BTSC10/Oreo/PCB/Kicad/Main-Board/v1.1/Melty_back.png

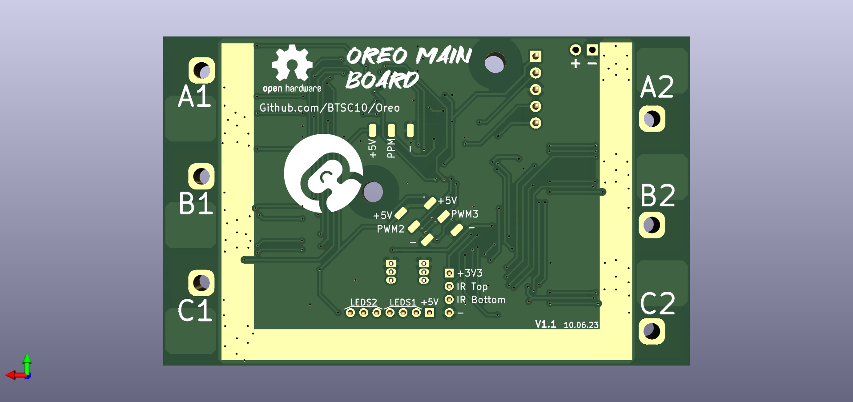
PCB/Kicad/Main-Board/v1.1/Melty_back.png
