BTSC10/Oreo/PCB/Kicad/Daughter-Board/Melty-daughter_top.png

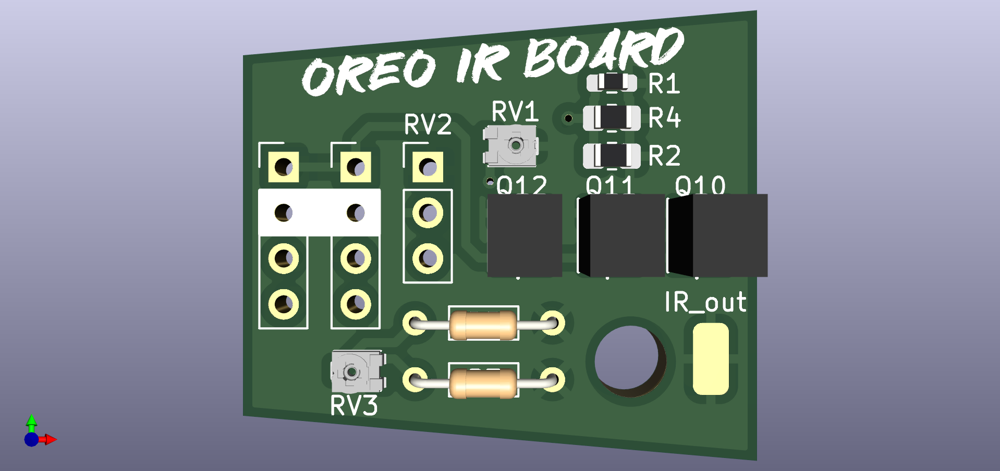
PCB/Kicad/Daughter-Board/Melty-daughter_top.png
