BTSC10/Oreo/README.md

# Broos
Beetle-weight Melty Brain Combat Robot.
(dont read me)
(please don't)
Ily's new edit

Name Ideas:
***********
Broos

You spin my head round

Oreo

<name>

Spinn

Oooga Booga

(Atak go) Brrr

Toothless
