BTSC10/Oreo/PCB/Oreo-v1.0-JLCPCB-invoice.pdf

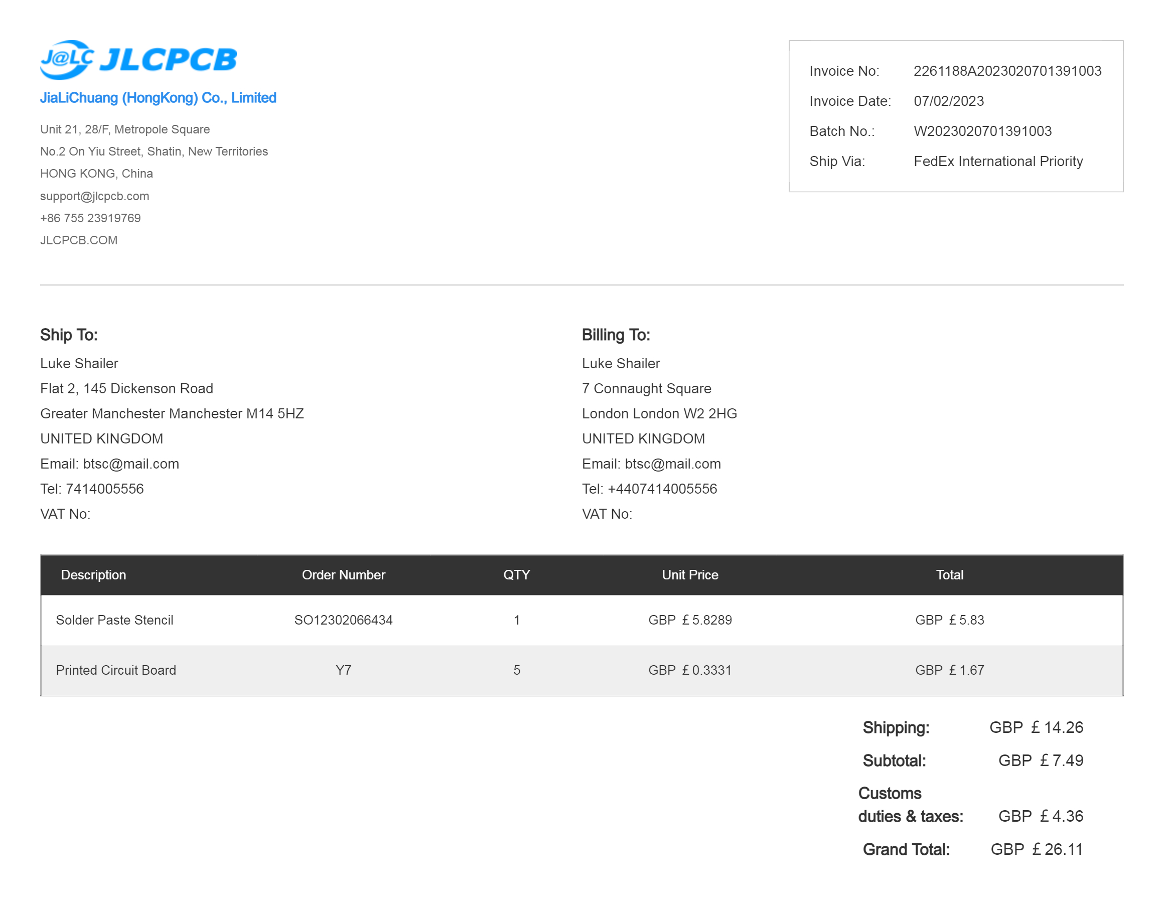
[picture p3: figure]
