BTSC10/Oreo/CAD/Render.JPG

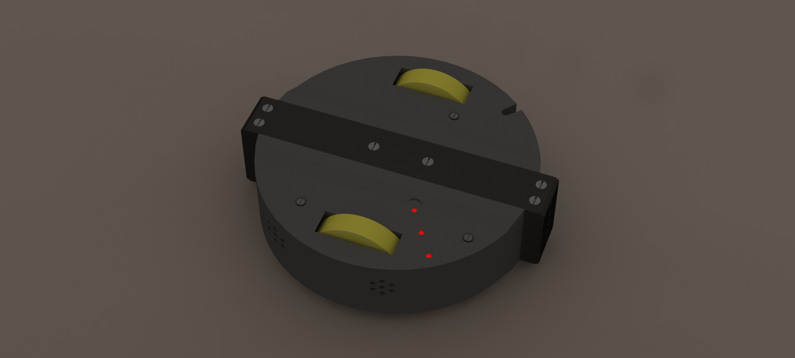
CAD/Render.JPG
