BTSC10/Oreo/PCB/Kicad/Beacon-driver/Beacon-driver_bottom.png

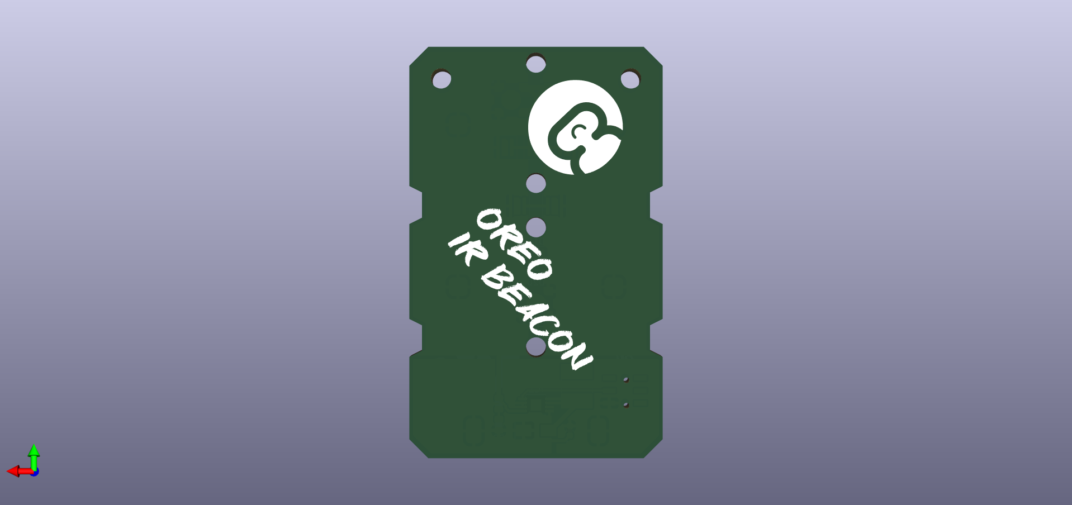
PCB/Kicad/Beacon-driver/Beacon-driver_bottom.png
