BTSC10/Oreo/PCB/Kicad/Beacon-driver/Beacon-driver_top.png

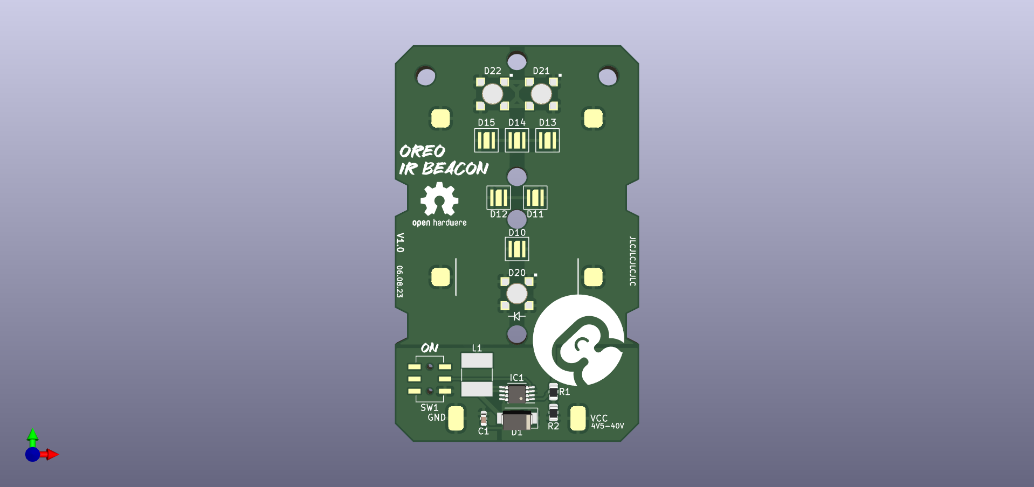
PCB/Kicad/Beacon-driver/Beacon-driver_top.png
