BTSC10/Oreo/PCB/Kicad/Daughter-Board/Melty-daughter_bottom.png

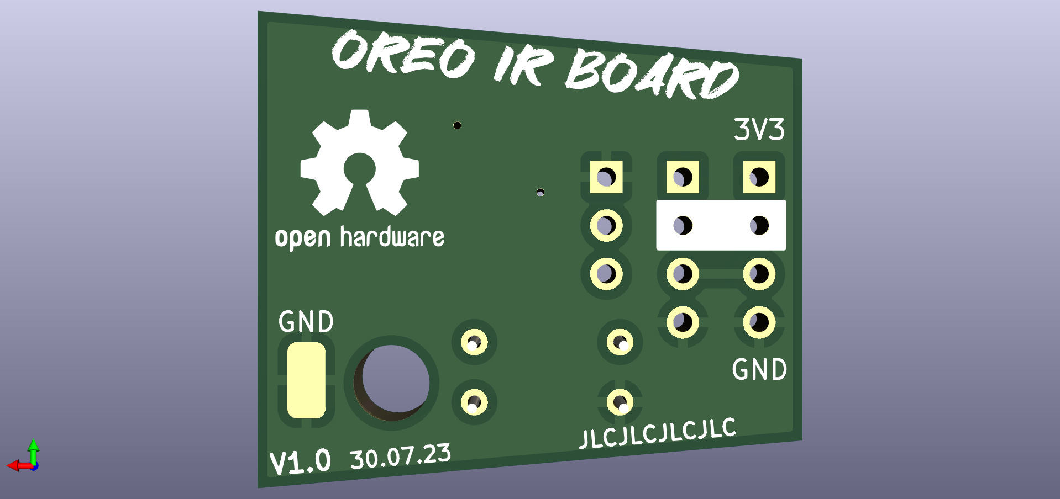
PCB/Kicad/Daughter-Board/Melty-daughter_bottom.png
