BTSC10/Oreo/PCB/Kicad/Main-Board/v1.1/Gerbers/drill_gen_settings.jpg

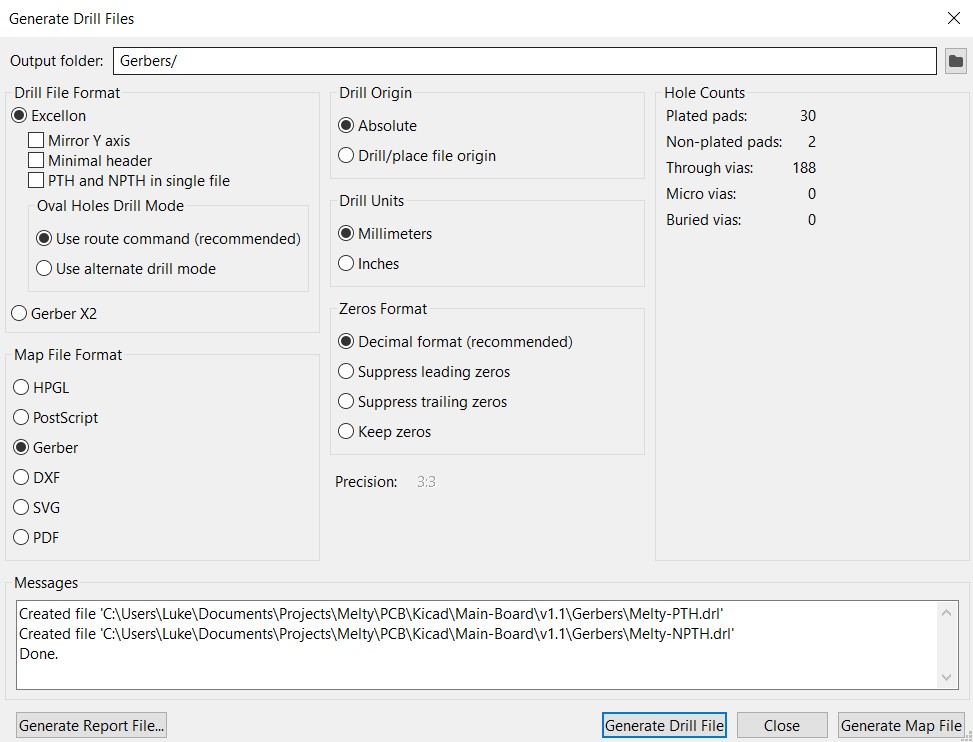
PCB/Kicad/Main-Board/v1.1/Gerbers/drill_gen_settings.jpg
