BTSC10/Oreo/PCB/Kicad/Main-Board/v1.1/Gerbers/gerber_gen_settings.jpg

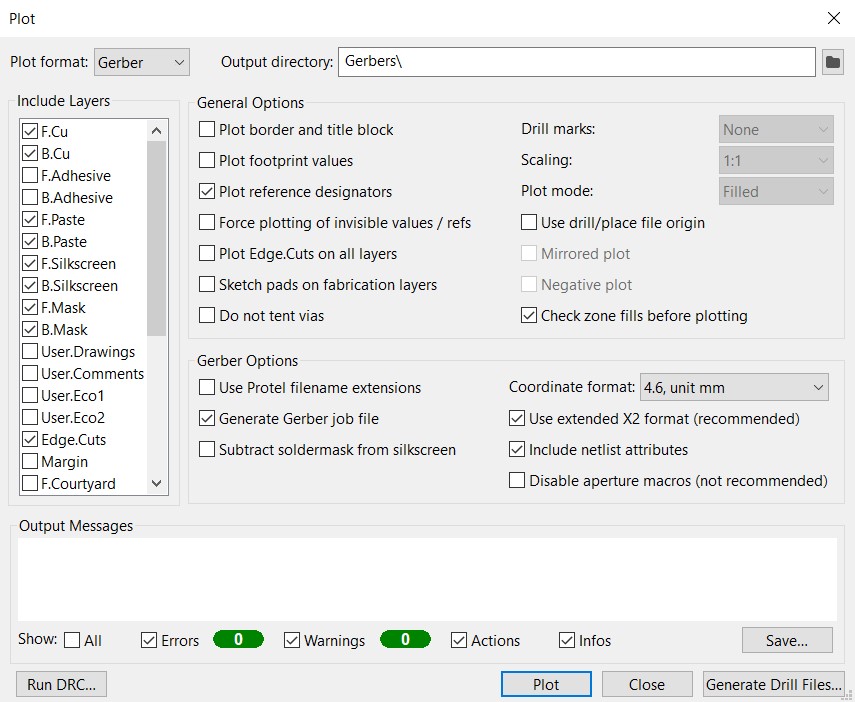
PCB/Kicad/Main-Board/v1.1/Gerbers/gerber_gen_settings.jpg
