BTSC10/Oreo/BOM.xlsx

Sheet: Main Board BOM
Ref | Man # | Min Qnty | Qnty | Unit Price | Description | Footprint | Supplier Link | Datasheet
AC1, | H3LIS331DLTR | 1 | 2 | £11.91 | Accelerometers Low Pwr Hi G 3-axis Digital Acceleromtr |  | https://www.digikey.co.uk/en/products/detail/H3LIS331DLTR/497-13903-1-ND/4311636 | https://www.st.com/content/ccc/resource/technical/document/datasheet/3e/48/02/c7/a4/e6/41/bb/DM00053090.pdf/files/DM00053090.pdf/jcr:content/translations/en.D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
C1, C16, C19, C20, C21, C22, C23, | CL21B105KAFNNNE | 7 | 20 | £0.057 | CAP CER 1UF 25V X7R 0805 | 0805 | https://www.digikey.co.uk/en/products/detail/samsung-electro-mechanics/CL21B105KAFNNNE/3886724 | https://media.digikey.com/pdf/Data%20Sheets/Samsung%20PDFs/CL21B105KAFNNNE_Spec.pdf
C2, C4, | TCC0402COG200J500AT | 2 | 100 | £0.001 | 50V 20pF C0G Â±5% 0402 Multilayer Ceramic Capacitors MLCC - SMD/SMT ROHS | 0402 | 100
C3, C5, C7, C14, | CL05A106MQ5NUNC | 4 | 50 | £0.003 | 6.3V 10uF X5R Â±20% 0402 Multilayer Ceramic Capacitors MLCC - SMD/SMT ROHS | 0402 | 50
C6, C17, C18, C24, C25, C26, C27, | CL31A106KAHNNNE | 7 | 20 | £0.110 | CAP CER 10UF 25V X5R 1206 | 1206 | https://www.digikey.co.uk/en/products/detail/samsung-electro-mechanics/CL31A106KAHNNNE/3886733
C8, | CC0402KRX7R9BB103 | 1 | 100 | £0.001 | 10nF | 0402 | 100
C9, | CL10A475KA8NQNC | 1 | 20 | £0.019 | 25V 4.7uF X5R Â±10% 0603 Multilayer Ceramic Capacitors MLCC - SMD/SMT ROHS | 0603 | 20
C10, C11, C12, C13, C15, | TCC0402X5R104M250AT | 5 | 200 | £0.001 | 25V 100nF X5R Â±20% 0402 Multilayer Ceramic Capacitors MLCC - SMD/SMT ROHS | 0402 | 200
D2, | XL-1608SYGC-06 | 1 | 50 |  | Green LED 25mA 2800K~3160K 575nm Colorless transparence -30â„ƒ~+85â„ƒ Positive post 570nm~573nm Green/Yellow-Green 120Â° 55mW 0603 Light Emitting Diodes (LED) ROHS | 0603 | 50
L1, | CBC3225T102KR | 1 | 10 |  | 1mH | 1210 | 10
Q1, Q2, Q5, Q6, Q7, Q8, Q9, Q10, Q11, Q12, Q13, Q14, | STD80N3LL | 12 |  |  |  | TO-252-2 | https://uk.farnell.com/stmicroelectronics/std80n3ll/mosfet-n-ch-30v-80a-to-252/dp/4036303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|pcrid|610187768070|&gclid=Cj0KCQjwz8emBhDrARIsANNJjS6BriV4xIs_x6XmtyKd7ZRa-XmyrBPjHKZbWgFfGnDnOGN-Ei2ZlYcaAudcEALw_wcB
Q1, Q2, Q5, Q6, Q7, Q8, Q9, Q10, Q11, Q12, Q13, Q14, | G35N02K | 12 | 24 | £0.371 | N-Channel 20 V 35A (Tc) 40W (Tc) Surface Mount TO-252 | TO-252-2 | https://www.digikey.co.uk/en/products/detail/goford-semiconductor/G35N02K/16584942 | http://www.gofordsemi.com/products-detail.php?ProId=637
R1, R4, R22, R23, R24, R25, R26, R27, | 0402WGJ0823TCE | 8 | 200 | £0.0004 | 82K | 0402 | 200
R3, | - | 1 | 50 |  | 500R | 0805 | 50
R5, R28, R29, R30, R31, R32, R33, | RC-02W1402FT | 7 | 200 | £0.001 | 14K | 0402 | 200
R6, R7, R10, R11, R12, R13, R14, R15, R16, R17, R18, R19, | ERJ-PA2F20R0X | 12 | 24 | £0.173 | RES 20 OHM 1% 1/4W 0402 | 0402 | https://www.digikey.co.uk/en/products/detail/panasonic-electronic-components/ERJ-PA2F20R0X/9815036
U1, | AP7375-33SA-7 | 1 | 3 | £0.370 | 3.3 V Linear Voltage Regulator IC Positive Fixed 1 Output 300mA SOT-23-3 | SOT-23 | https://www.digikey.co.uk/en/products/detail/diodes-incorporated/AP7375-33SA-7/16400213 | https://www.diodes.com/assets/Datasheets/AP7375.pdf
U2, U8, | NCR421UX | 0 | 10 | £0.380 | IC LED DRVR LIN PWM 150MA 6TSOP | TSOP-6_1.65x3.05mm_P0.95mm | https://www.digikey.co.uk/en/products/detail/nexperia-usa-inc/NCR421UX/9998332
U3, | STM32F303RBTx | 1 | 10 | £4.500 | ARM Cortex-M4 MCU, 128KB flash, 32KB RAM, 72MHz, 2-3.6V, 52 GPIO, LQFP-64 | LQFP-64_10x10mm_P0.5mm | 10
U4, U7, | DRV8300DRGER | 2 | 5 | £1.400 | 100-V MAX SIMPLE 3-PHASE GATE DR | VQFN-24-1EP_4x4mm_P0.5mm_EP2.45x2.45mm | https://www.digikey.co.uk/en/products/detail/texas-instruments/DRV8300DRGER/13918763 | https://www.ti.com/lit/ds/symlink/drv8300.pdf?HQS=dis-dk-null-digikeymode-dsf-pf-null-wwe&ts=1667935104197
U10, | PJ73AL50SQ | 1 | 10 | £0.102 | 300mA 300mV@(100mA) Fixed 5V~5V Positive 1 20V SOT-89 Linear Voltage Regulators (LDO) ROHS | SOT-89-3 | 10
Y1, | 2344-RH100-32.000-20-F-5050-TR-NS1CT-ND | 1 | 10 |  | CRYSTAL 32.0000MHZ 20PF SMD | Crystal_SMD_3225-4Pin_3.2x2.5mm | 10
 | PCB | 1 | 10 | £0.400
 | Total: | £27.83 | £103.26

Sheet: IR Board BOM
Ref | Man # | Min Qnty | Qnty | Unit Price | Description | Footprint | Supplier Link | Datasheet
D1, D2, | B3803FCH-20C001112U1930 | 0 | 8 | £0.180 | LED RGB FULL COLOR 1.6X1.6 | - | https://www.digikey.co.uk/en/products/detail/harvatek-corporation/B3803FCH-20C001112U1930/13588742
Q1, | SFH 325 | 1 | 10 | £0.640 | SENSOR PHOTO 980NM SIDE VIEW SMD |  | https://www.digikey.co.uk/en/products/detail/osram-opto-semiconductors-inc/SFH-325-FA-3-4-Z/3880928
RV1, | TC42X-2-102E | 1 | 5 | £0.430 | TRIMMER 1K OHM 0.1W J LEAD TOP | - | https://www.digikey.co.uk/en/products/detail/bourns-inc/TC42X-2-102E/3722194
 | PCB | 1 | 5 | £0.400
 | Total: | £1.47 | £11.99
 | 2 units needed

Sheet: IR Beacon BOM
Ref | Man # | Min Qnty | Qnty | Unit Price | Description | Footprint | Digikey Link | Datasheet
IC1 | AL8860MP-13 | 1 | 4 | £0.73 | LED Driver, 1 Output, Buck (Step Down), 4.5 V to 40 V in, 1 MHz switch, PWM, 40V/1.5 A out, MSOP-8 | MSOP-8 | https://uk.farnell.com/diodes-inc/al8860mp-13/led-driver-buck-1mhz-msop-8/dp/2709526
L1 | VLS6045EX-470M-H | 1 | 3 | £0.360 | Power Inductor (SMD), AEC-Q200, 47 µH, 1.3 A, Semishielded, 1.8 A, VLS-EX-H | - | https://uk.farnell.com/tdk/vls6045ex-470m-h/inductor-aec-q200-47uh-semi-shld/dp/3288287 | https://www.farnell.com/datasheets/2875164.pdf
D2 | ES2AA | 1 | 5 | £0.080 | Fast / Ultrafast Diode, 50 V, 2 A, Single, 920 mV, 25 ns, 50 A | SMA? | https://uk.farnell.com/diodes-inc/es2aa/diode-rectif-s-fast-2a-50v-sma/dp/2061427 | https://www.farnell.com/datasheets/2211370.pdf
R1 | MFLA0805R1000FA | 1 | 10 | £0.090 | SMD Current Sense Resistor, 0.1 ohm, MFLA Series, 0805 [2012 Metric], 250 mW, ± 1%, Metal Film | 0805 | https://fr.farnell.com/en-FR/eaton-bussmann/mfla0805r1000fa/res-r1-1-0-25w-metal-film-0805/dp/4070738
D0x | LZ1-10R702-0000 | 1 | 2 | £8.330 | Infrared (IR) Emitter 940nm 3V 1.2A 90° Star Array | Star Array | https://www.digikey.co.uk/en/products/detail/osram-opto-ams-osram/LZ1-10R702-0000/4976715
D1x | SE03-EMC3838A-C90-940 | 1 | 3 | £1.580 | 180mW~240mW 1000mA 1.3V~1.7V 1.7W 930nm~960nm SMD,3.9x3.9mm Infrared (IR) LED |  | https://www.lcsc.com/product-detail/Infrared-IR-LEDs_XSSY-SE03-EMC3838A-C90-940_C5205231.html
SW1 | TA-3539S-A1 | 1 | 10 | £0.101 | SMD,4x7.2mm Slide Switche |  | https://www.lcsc.com/product-detail/Slide-Switches_Yuandi-TA-3539S-A1_C514054.html | https://datasheet.lcsc.com/lcsc/2004181005_Yuandi-TA-3539S-A1_C514054.pdf
 | PCB | 1 | 5 | £0.800
 | Total: | £12.07 | £31.71

Sheet: Mechanical
Part Name | Material | Volume | Weight | Qty | Unit Price | Link
chassis_poly_top | polycarb | 318419 | 159.2095 | 1 |  |  | Density
chassis_poly_bottom | polycarb | 838261 | 419.1305 | 1 |  |  | HDPE | 0.00095
weapon_bar | Al | 59807.32 | 468.8893888 | 0 |  |  | Silicon | 0.00100
weapon_tooth | tool steel | 72054.76 | 564.9093184 | 0 |  |  | AL | 0.00270
 |  |  |  |  |  |  | Steel | 0.00784
 |  |  |  |  |  |  | ABS | 0.001
3d aim | 550 | 578.34 |  | 1
metal aim | 700 | 684.88 | 684.88 | 1 |  | 2067.597414
Wheel_Inner | ABS? | 2000 | 2 | 2
Wheel_Outer | Silicon | 5000 | 5 | 2
M3 10-15mm contersunk screw | - |  | 1 | 16
prop 2830 800kv |  |  | 65 | 2 | £18.43 | https://hobbyking.com/en_us/propdrive-v2-2830-800kv-brushless-outrunner-motor.html
1100mah 4s LiPo |  |  | 137 | 1 | £18.55 | https://www.hobbyrc.co.uk/gnb-1100mah-4s-130c-lipo-battery
Oreo PCB |  |  |  | 1 | £27.83
Daughter PCB |  |  |  | 1
RX |  |  | 5 | 1
Safety Link |  |  |  | 1
Power LED |  |  |  | 1
 | Total Weight: |  | 1565.22
 | Delta: |  | -65.22
1kg 85A Rubber |  |  |  | 1 | £24.00 | https://www.mbfg.co.uk/pt-flex-85-rubber.html
250g softner |  |  |  | 1 | £25.00 | https://www.mbfg.co.uk/7475-c-softener.html
1kg Load Cell |  |  |  | 1 | £4.99 | https://www.amazon.co.uk/ARCELI-Converter-Breakout-Portable-Electronic/dp/B07MY35F92/ref=sr_1_5

Sheet: Calculator
Bar
Diameter | Width | Thickness | Volume | Weight | Target
225 | 35 | 3.2 | 25200 | 68.04 | 175
 |  |  |  |  |  | 750
Tooth
Depth | Width | Height | Volume
20 | 35 | 50 | 35000 | 274.4 | 200
 |  |  |  | 684.88 | 700
Balance
4 | 25 | 50 | 5000 | 39.2 | 50
# | di
5 | 5 |  | 1570.796327 | 12.3150432
 |  |  |  | 51.5150432
