BTSC10/Oreo/CAD/XT60E-F.SLDASM

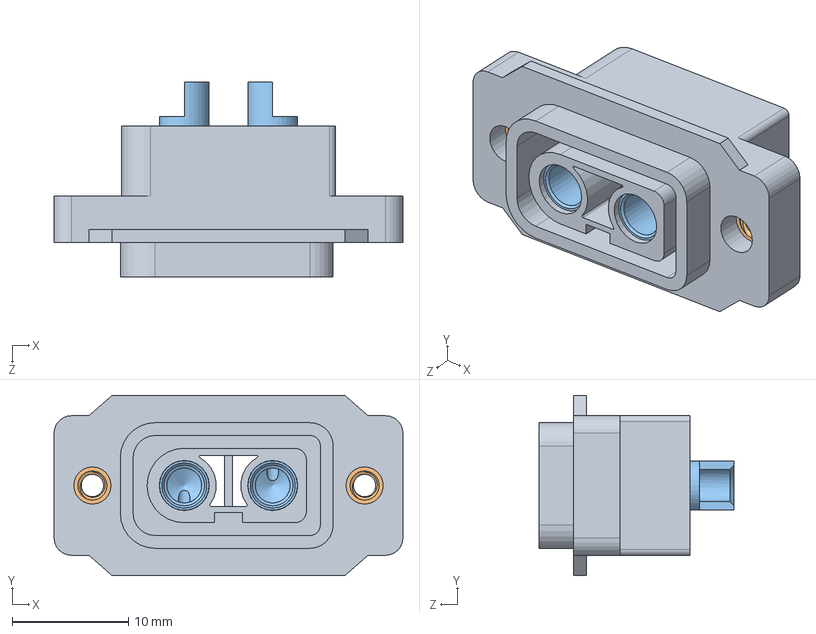
[picture p11: CAD file, 2023-02-22]
CAD/XT60E-F.SLDASM
30.0 x 15.5 x 16.8 mm
Nylon Housing.step
M2.5 Nut.step x 2
Socket 3.5mm.step x 2
