BTSC10/Oreo/CAD/motor_assem.SLDASM

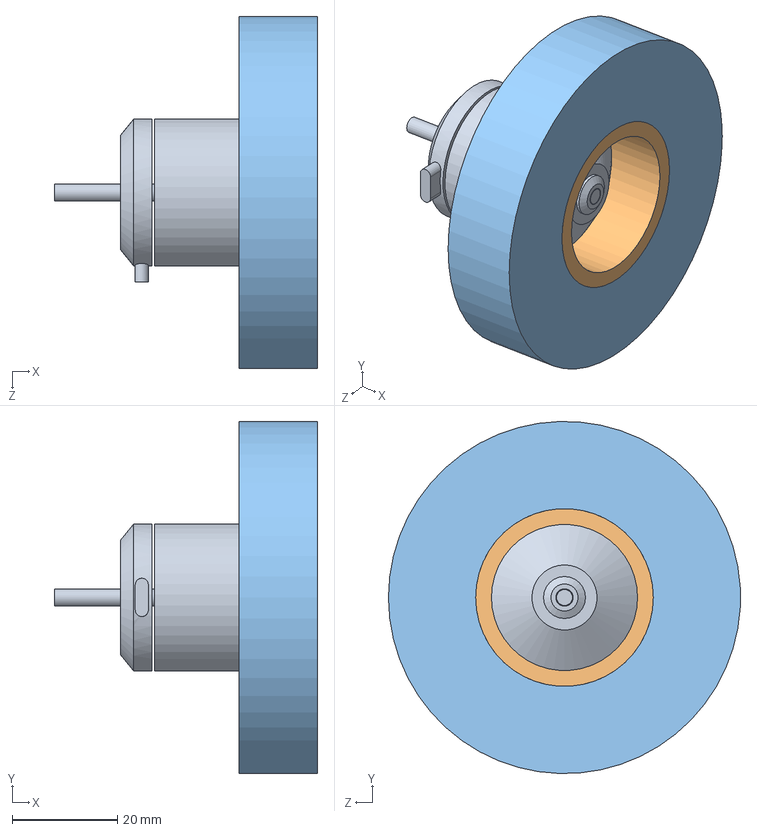
[picture p12: CAD file, 2023-02-22]
CAD/motor_assem.SLDASM
50.1 x 67.0 x 67.0 mm
prop_2830_800kv
DesignA
wheel_silicon
