BTSC10/Oreo/CAD/chassis_poly_top.SLDPRT

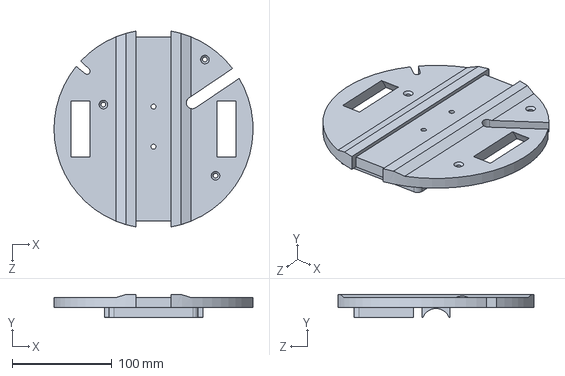
[picture p13: CAD file, 2023-03-05]
CAD/chassis_poly_top.SLDPRT
199.9 x 23.4 x 196.9 mm
