BTSC10/Oreo/CAD/Wheels/Design 1.SLDPRT

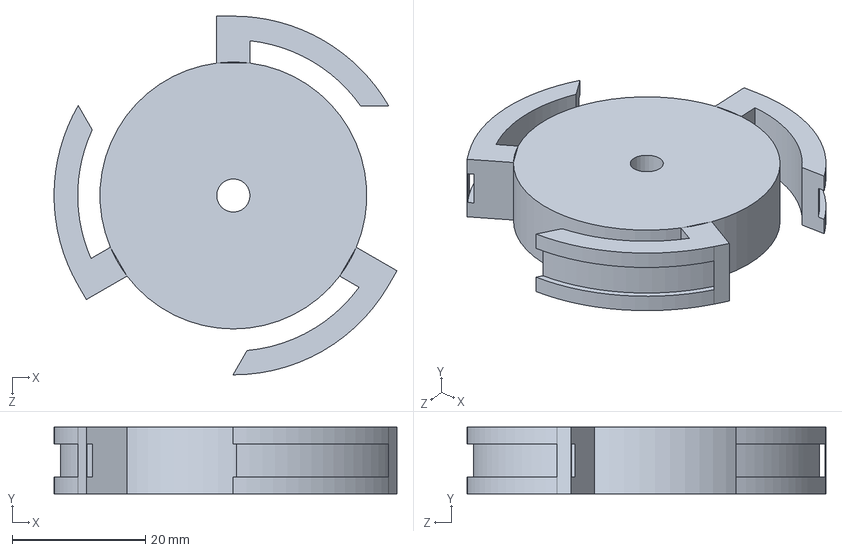
[picture p14: CAD file, 2023-03-08]
CAD/Wheels/Design 1.SLDPRT
51.6 x 10.0 x 53.9 mm
