BTSC10/Oreo/CAD/chassis_poly_bottom.SLDPRT

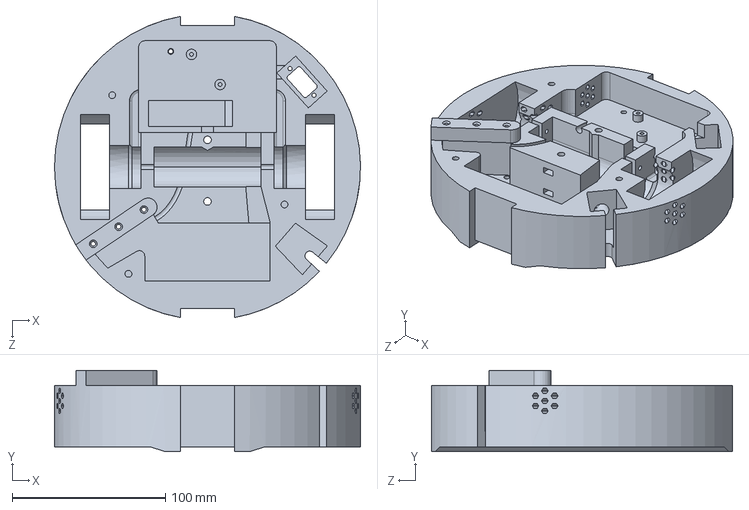
[picture p15: CAD file, 2023-03-05]
CAD/chassis_poly_bottom.SLDPRT
200.0 x 53.2 x 196.9 mm
