BTSC10/Oreo/CAD/Wheels/Wheel mould.SLDPRT

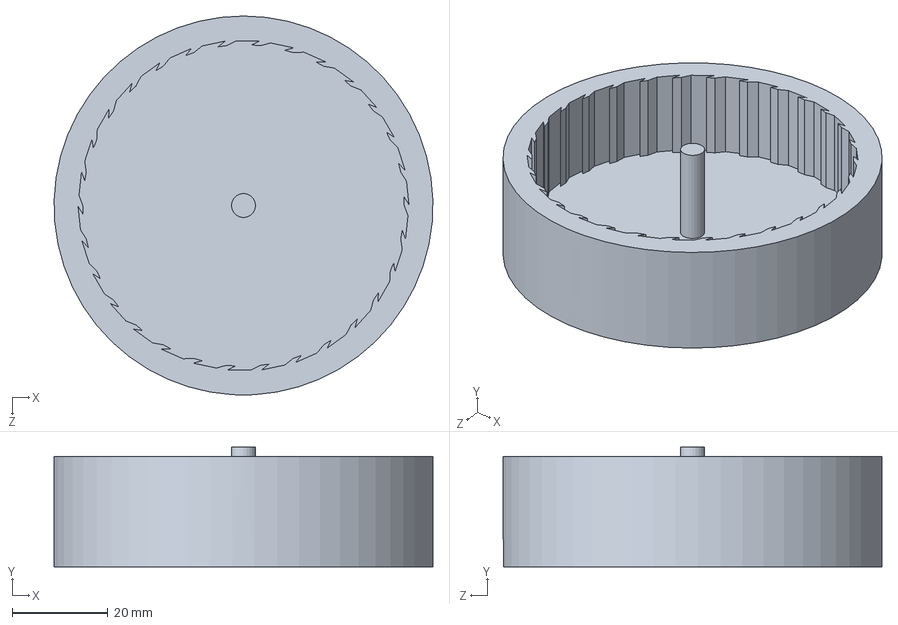
[picture p16: CAD file, 2023-03-08]
CAD/Wheels/Wheel mould.SLDPRT
79.0 x 25.0 x 79.0 mm
