BTSC10/Oreo/CAD/3mm_LED.SLDPRT

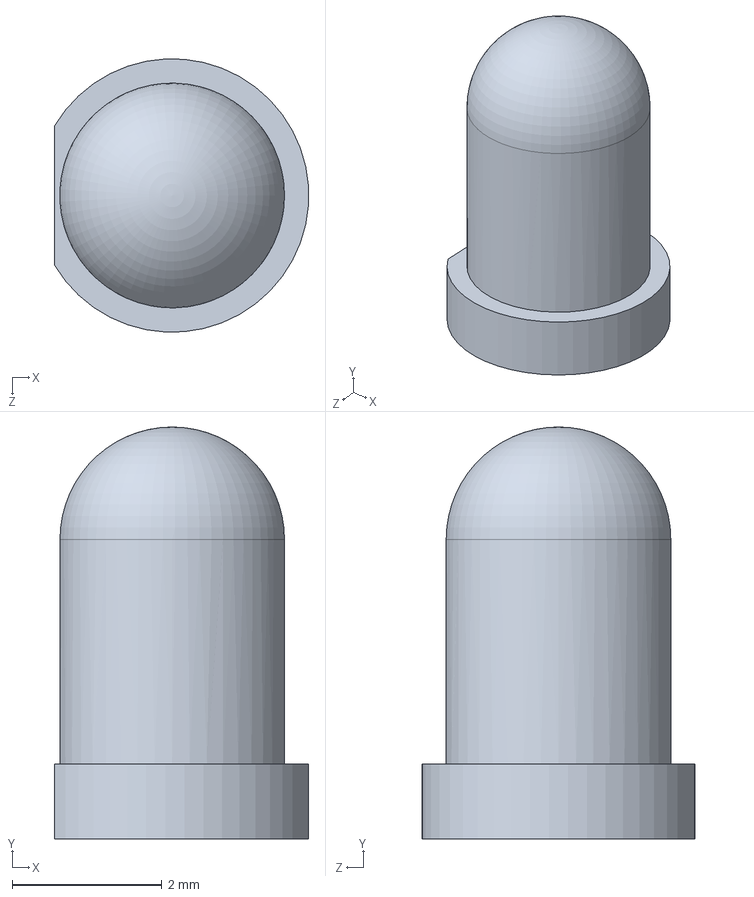
[picture p17: CAD file, 2023-02-22]
CAD/3mm_LED.SLDPRT
3.39 x 5.50 x 3.65 mm
