BTSC10/Oreo/CAD/Wheels/ruber.SLDPRT

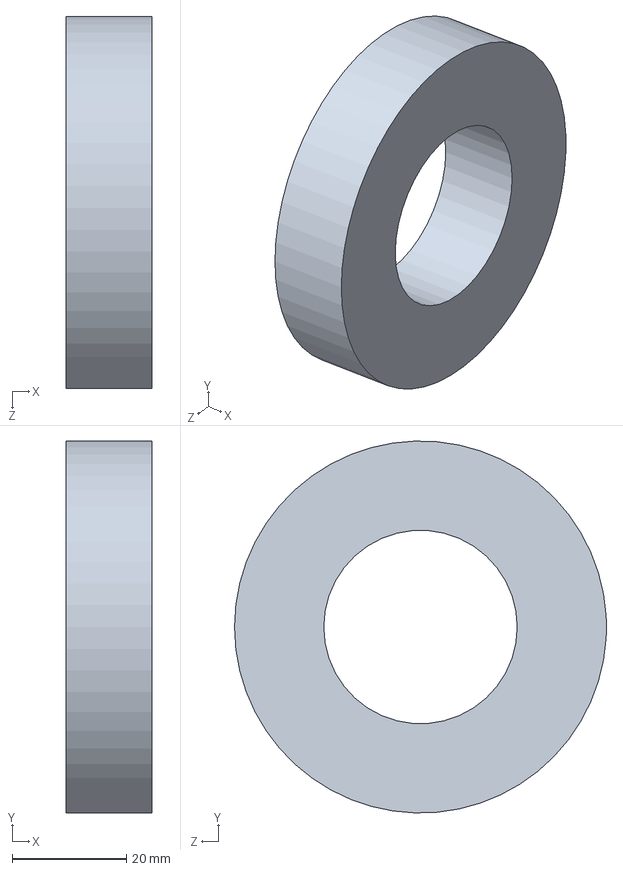
[picture p18: CAD file, 2023-02-22]
CAD/Wheels/ruber.SLDPRT
15.0 x 65.0 x 65.0 mm
