BTSC10/Oreo/CAD/Wheels/wheel_silicon.SLDPRT

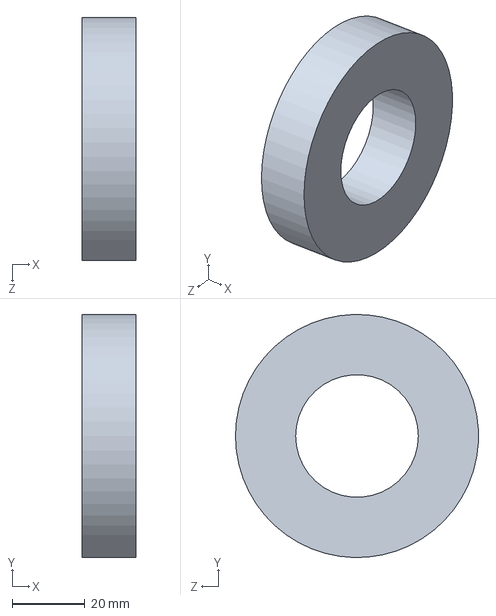
[picture p19: CAD file, 2023-02-22]
CAD/Wheels/wheel_silicon.SLDPRT
15.0 x 67.0 x 67.0 mm
