BTSC10/Oreo/CAD/daughter_pcb.SLDPRT

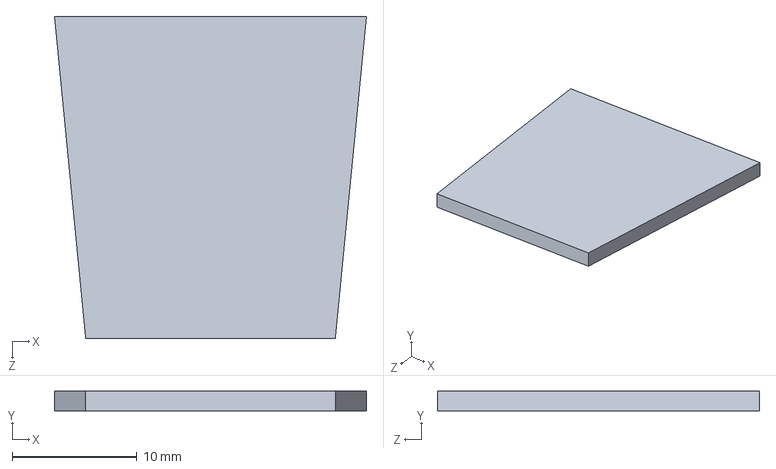
[picture p21: CAD file, 2023-02-22]
CAD/daughter_pcb.SLDPRT
25.0 x 1.60 x 25.8 mm
