BTSC10/Oreo/CAD/Wheels/DesignA.SLDPRT

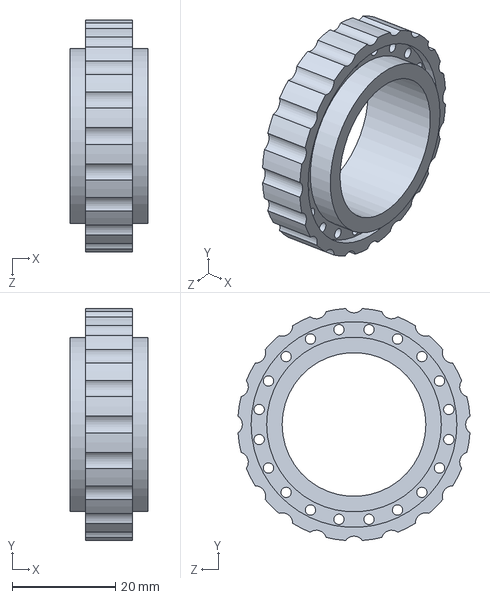
[picture p22: CAD file, 2023-02-22]
CAD/Wheels/DesignA.SLDPRT
15.0 x 44.9 x 44.9 mm
