BTSC10/Oreo/CAD/daughter_pcb_spacer_bottom.SLDPRT

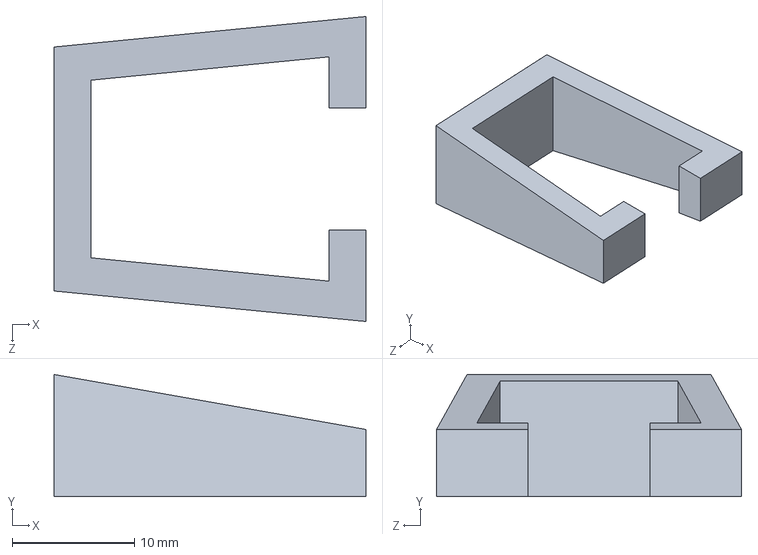
[picture p23: CAD file, 2023-02-22]
CAD/daughter_pcb_spacer_bottom.SLDPRT
25.5 x 10.0 x 25.0 mm
