BTSC10/Oreo/CAD/battery.SLDPRT

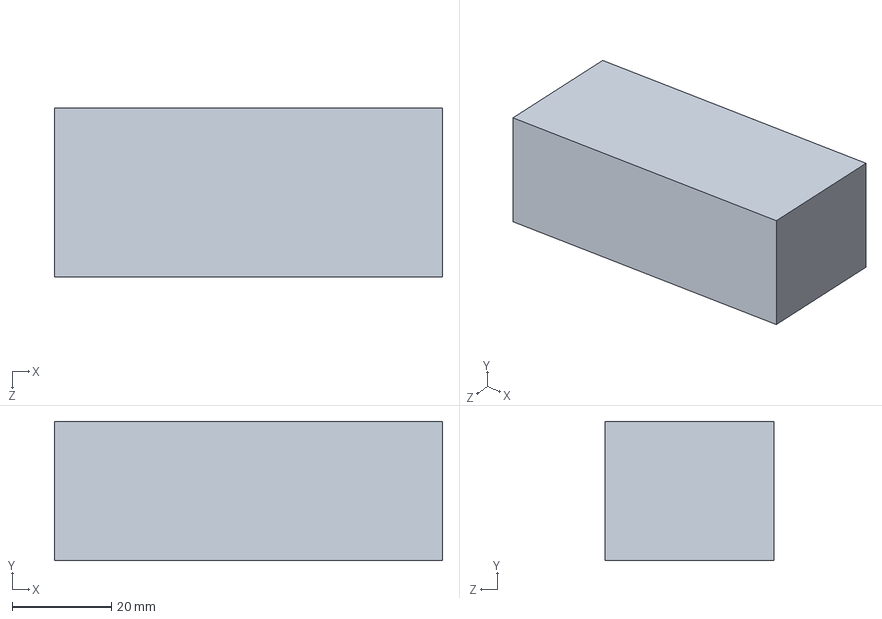
[picture p24: CAD file, 2023-02-22]
CAD/battery.SLDPRT
78.0 x 28.0 x 34.0 mm
