BTSC10/Oreo/CAD/prop_2830_800kv.SLDPRT

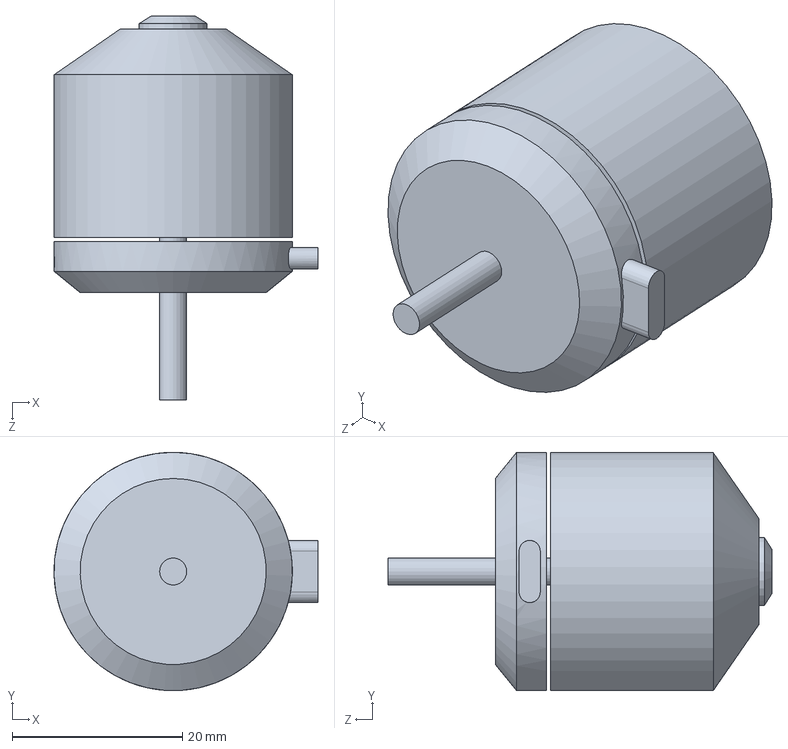
[picture p25: CAD file, 2023-02-22]
CAD/prop_2830_800kv.SLDPRT
31.0 x 28.0 x 45.1 mm
