BTSC10/Oreo/CAD/weapon_bar.SLDPRT

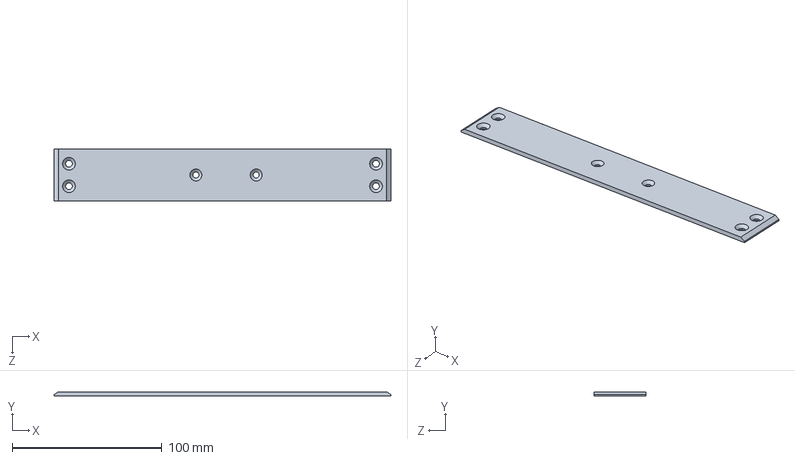
[picture p26: CAD file, 2023-02-22]
CAD/weapon_bar.SLDPRT
225.0 x 3.00 x 35.0 mm
