BTSC10/Oreo/CAD/weapon_tooth.SLDPRT

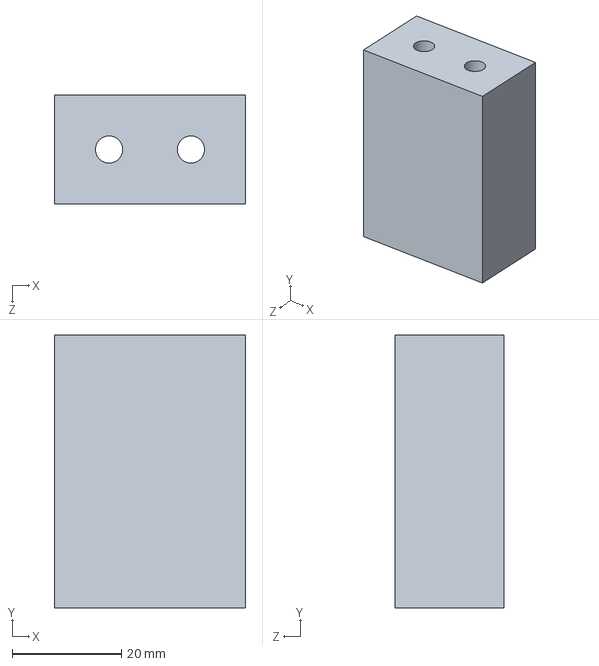
[picture p27: CAD file, 2023-02-22]
CAD/weapon_tooth.SLDPRT
35.0 x 50.0 x 20.0 mm
