BTSC10/Oreo/CAD/daughter_pcb_spacer.SLDPRT

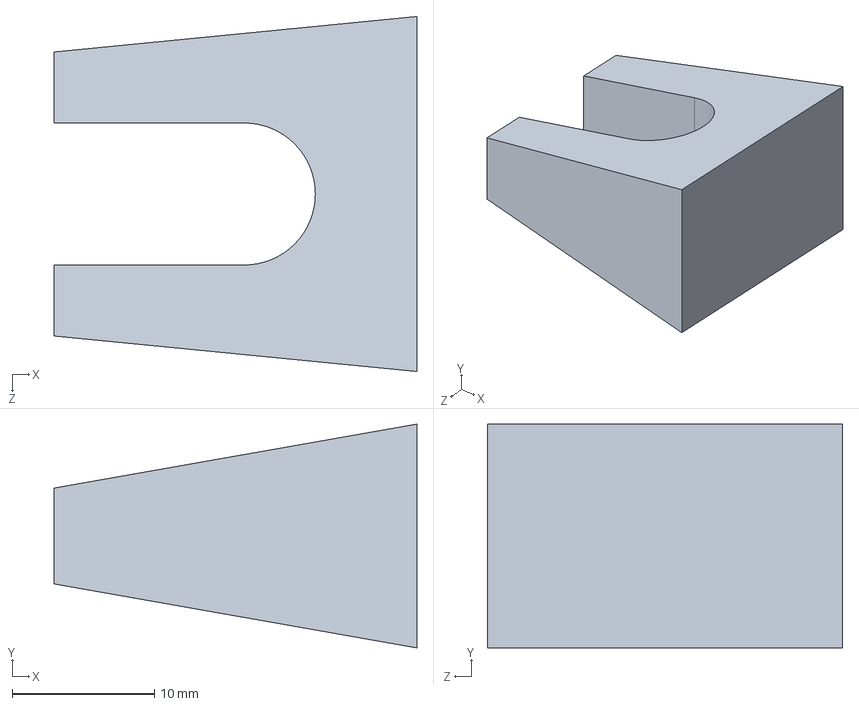
[picture p28: CAD file, 2023-02-22]
CAD/daughter_pcb_spacer.SLDPRT
25.5 x 15.8 x 25.0 mm
