BTSC10/Oreo/CAD/Wheel.SLDPRT

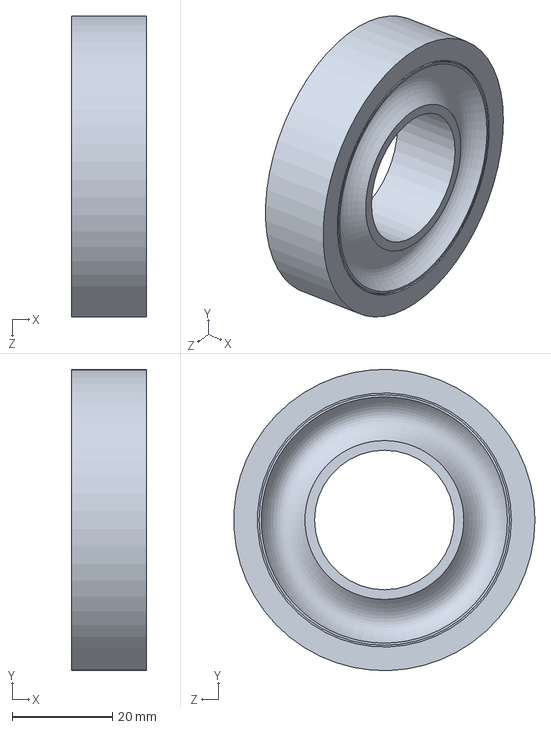
[picture p29: CAD file, 2022-12-09]
CAD/Wheel.SLDPRT
15.0 x 60.0 x 59.9 mm
