BTSC10/Oreo/CAD/C2836_Brushless_Motor.SLDPRT

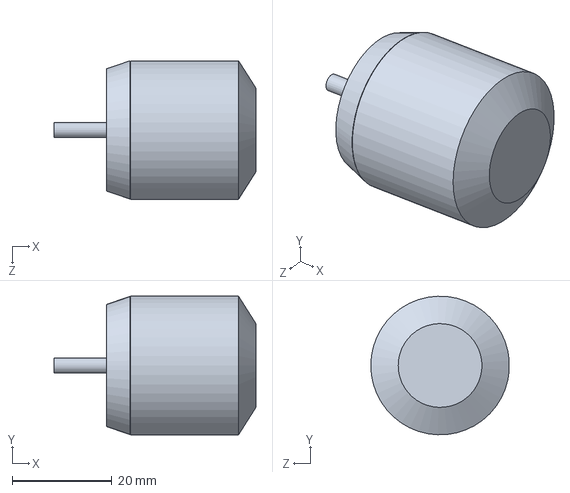
[picture p30: CAD file, 2022-12-09]
CAD/C2836_Brushless_Motor.SLDPRT
40.5 x 27.8 x 27.8 mm
