BTSC10/Oreo/CAD/Mock_PCB.SLDPRT

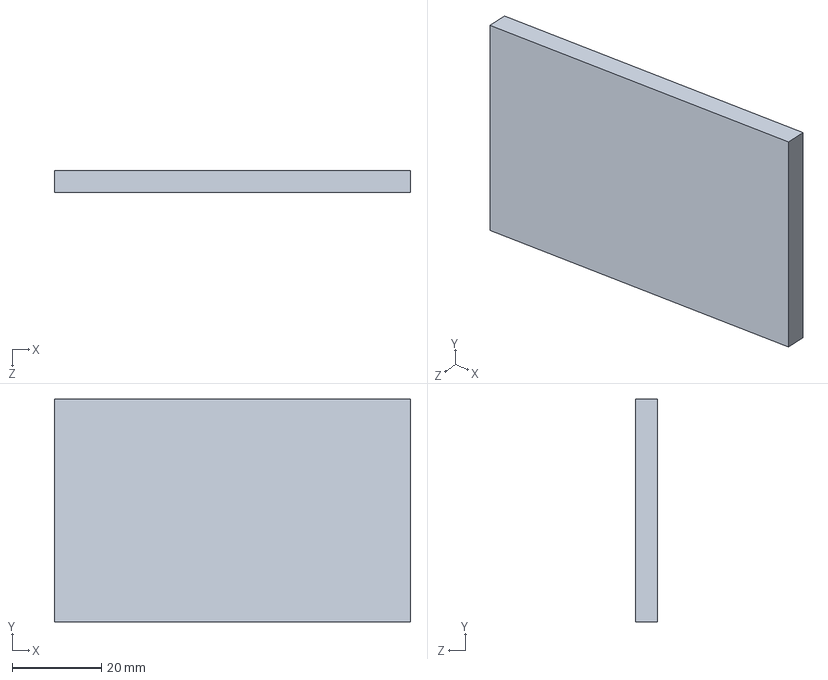
[picture p31: CAD file, 2022-12-09]
CAD/Mock_PCB.SLDPRT
80.0 x 50.0 x 5.00 mm
