BTSC10/Oreo/(list of files, cad)

Other CAD files:
CAD/Wheels/Socket 3.5mm.step.SLDPRT
CAD/Wheels/Nylon Housing.step.SLDPRT
CAD/Archive/Lasercut_layout.SLDASM
CAD/Archive/Lower_Top_Plate.SLDPRT
CAD/Archive/Melty.SLDASM
CAD/Archive/Mid_Plate.SLDPRT
CAD/Archive/Motor_Shim.SLDPRT
CAD/Archive/Outer_Ring.SLDPRT
CAD/Archive/Upper_Top_Plate.SLDPRT
CAD/Archive/Wheel.SLDPRT
CAD/Archive/battery_box_front.SLDPRT
CAD/Archive/battery_box_side.SLDPRT
CAD/Archive/daughter_pcb.SLDPRT
CAD/Archive/inner_bracket.SLDPRT
CAD/Archive/outer_braket.SLDPRT
CAD/Archive/skeleton_components.SLDASM
CAD/Archive/tooth.SLDPRT
CAD/Wheels/Design 1.STL
CAD/Wheels/M2.5 Nut.step.SLDPRT
CAD/m3_bolt.SLDPRT
CAD/m5_bolt.SLDPRT
CAD/m5_nut.SLDPRT
CAD/stl_files/chassis_poly_bottom.STL
CAD/stl_files/chassis_poly_top.STL
