BTSC10/Oreo/(threads)

Thread 1 (2023-03-08):

Redesign Daughter Boards

Kv1n20, 2023-03-08:

Thread 2 (2023-03-08):

3D Print Wheel Hubs

Kv1n20, 2023-03-08:
now that we have silicon we should 3d print some wheel inner hubs (even tho they wont fit the motors exactly) so we can start testing silicon

Closed 2023-03-16.

Thread 3 (2023-03-08):

Finalize Wheel Dimensions

Kv1n20, 2023-03-08:

BTSC10, 2023-03-08:
waiting for motors to arrive

BTSC10, 2023-10-28:
Motors have arrived, all have ODs of around 28.05 mm.
We will need to do some test prints and dial in the press fit dimension of the wheel ID

Thread 8 (2023-03-08):

PPM from receiver

Kv1n20, 2023-03-08:

BTSC10, 2023-08-27:
Done

- Might be worth adding a first order filter to the inputs in case we get junk data for one frame

Closed 2023-08-27.

Thread 9 (2023-03-08):

SPI from accelerometer

Kv1n20, 2023-03-08:

BTSC10, 2023-03-08:
H3LIS331DLTR

Kv1n20, 2023-03-08:
Using HAL

Kv1n20, 2023-03-08:
https://controllerstech.com/how-to-use-spi-with-stm32/
https://stackoverflow.com/questions/53122936/stm32-spi-communication

BTSC10, 2023-03-09:
just for reference these are the initial params we need to set for the SPI interface

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

BTSC10, 2023-06-07:
changed CPOL = 1, CPHA = 1 to match datasheet timing diagram

MISO line and clock
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

MOSI line and clock
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

during the first 8 clock pulses, the MISO line sends out 0b10001111 trying to read WHO-AM-I
during the next 8 cycles the MISO line sends out junk (the same bytes)

the MOSI line responds with 0b00110100 during the second byte of clock pulses but also sends out this data during the first byte. This is not expected and not shown in the datasheet

BTSC10, 2023-06-07:
Ok I think the issue is the Chip select pin on the accelerometer. It hardwired to ground as it is the only device on the SPI bus but that might be causing issues (https://electronics.stackexchange.com/questions/273157/can-ss-pin-be-tied-low-if-only-one-spi-device-is-used). The accel chip might need the pin to be pulled low before each transmission and brought back high afterwards

every time the device is power cycled, it responds to the first request sent to it. After that it just repeats that byte over and over no matter what request is made. This would explain why we are seeing a response in the first 8 bits of each transmission as well as the second.

To fix this we either need to try and bodge the PCB or design a v2:
This is the current design and pin 8 is the SPI enable/chip select pin. It would probably be easy to cut the trace that leads to pin 8. The issue would be getting a wire to that pin/pad during or after assembly. The grey box (AC1) shows the rough footprint of the accelerometer chip.
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

BTSC10, 2023-10-14:
PCB V1.1 added CHIP SELECT signal. SPI and AC1 tested and working

Closed 2023-10-14.

Thread 13 (2023-03-16):

MOSFETs: Failing

BTSC10, 2023-03-16:

BTSC10, 2023-06-02:
We forgot about the bootstrap capacitor. This cap needs to charge before it can drive the gate high. Therefore the circuit has a minimum frequency and can't be tested at steady state.

Test 1:
running a test script that operates B2_INH and B2_INL complementarily at a frequency of ~250 Hz
B2 is successfully pulled to 0 V and +BATT (9 V)
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

Note: 250 Hz is pretty slow and pretty close to the limit for the bootstrap circuit. a carrier frequency of ~50kHz makes more sense.

Closed 2023-06-02.

Thread 14 (2023-06-02):

G35N02K MOSFET maximum gate voltage

BTSC10, 2023-06-02:
The current G35N02K MOSFETs have a maximum gate voltage of +-12 V (yeh whoops feels like I maybe should have spotted that earlier). This is incompatible with the 4s maximum voltage of 16.8 V
The MOSFETs can be swapped out for STD80N3LL MOSFETs which have the same SMD footprint and a maximum gate voltage of +-20 V.

BTSC10, 2023-10-14:
STD80N3LL MOSFETs tested at ~16V:
all good, motor spins

Closed 2023-10-14.

Thread 15 (2023-06-06):

Possible improvements for a V2

BTSC10, 2023-06-06:
- [ ] smaller bootstrap caps
- [ ] smaller MOSFET gate resistors
- [ ] better silkscreen: (J1, J11, AC1 directions, phase labels)
- [ ] separate ground planes (AGND, DGND, PGND)
- [ ] multi PCB assembly (separate power stage and control boards)
- [ ] hand soldered components on underside to reduce form factor
- [ ] overvoltage protection for STM and analog ins

BTSC10, 2023-06-07:
Although its possible we don't need overvoltage protection for the analog inputs cuz the body diode in the MOSFETs caps the voltage

BTSC10, 2023-10-03:
For V1.3:

- [ ] C1 silkscreen
- [ ] increased solder mask clearance for power mosfets
- [ ] C9 0603 footprint 0402 component?
- [ ] 4 layer board for power distribution? (Signal, +Batt, GND, Signal)

Thread 16 (2023-06-13):

LED Driver Switching Frequency

BTSC10, 2023-06-13:
Working on the Beacon Driver circuit:
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

The switching frequency is not consistent with what is expected:
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
https://www.diodes.com/assets/Datasheets/AL8860.pdf

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

Thread 17 (2023-06-16):

High Speed External Clock Init issues

BTSC10, 2023-06-16:
Whenever I try to use the HSE clock source as the stm32 system clock, `SystemClock_Config();` throws as error. I haven't probed the clock to see what its up to yet.

BTSC10, 2023-10-15:
Clock config for PPM test uses HSE without error:
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

BTSC10, 2023-10-15:
CubeIDE might have a bug where its not possible to change HSE Prediv Value:
Restarting CubeIDE and copying settings above appears to solve HSE issues

Closed 2023-10-15.

Thread 18 (2023-10-06):

Mechanical Improvements

BTSC10, 2023-10-06:
- [ ] Larger Clearance for LED retaining shelf diam (> 4 mm)
- [ ] Smaller Diam for Lid screw heat set insert
- [ ] Reduce diam for 3 through Lid screws (from heatset diam to M3 3 mm cad, drilled out if required)
- [ ] clean up safety link (increase min thickness)
- [ ] safety link chamfer
- [ ] weapon bar small chamfer (for assembly)

Thread 19 (2023-10-28):

ADC High Input Impedance

BTSC10, 2023-10-28:
Running an ADC test script. ADC readings appear to be dependant on the time between reads.

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

The problem is probably the high input impedance from the voltage divider as described in https://stackoverflow.com/questions/75058066/stm32-adc-reading-instability

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

This issue will also occur with the ESC phase sense signals.

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

Thread 20 (2023-10-28):

IR Board Doesn't fit

BTSC10, 2023-10-28:
No clue what I did but the IR Board PCB does not fit in the chassis. This should be an easy fix with a fret saw, disc sander or maybe Dremel but might be a bit of a pain because FR-4 isn't great for the lungs.

About 3 mm needs to be removed from the right side of the PCB.

This will ruin the Front mounting position for the IR sensor (Q10) but the PCB should still work
