BTSC10/Oreo/PCB/Kicad/Daughter-Board/Melty-daughter.pdf

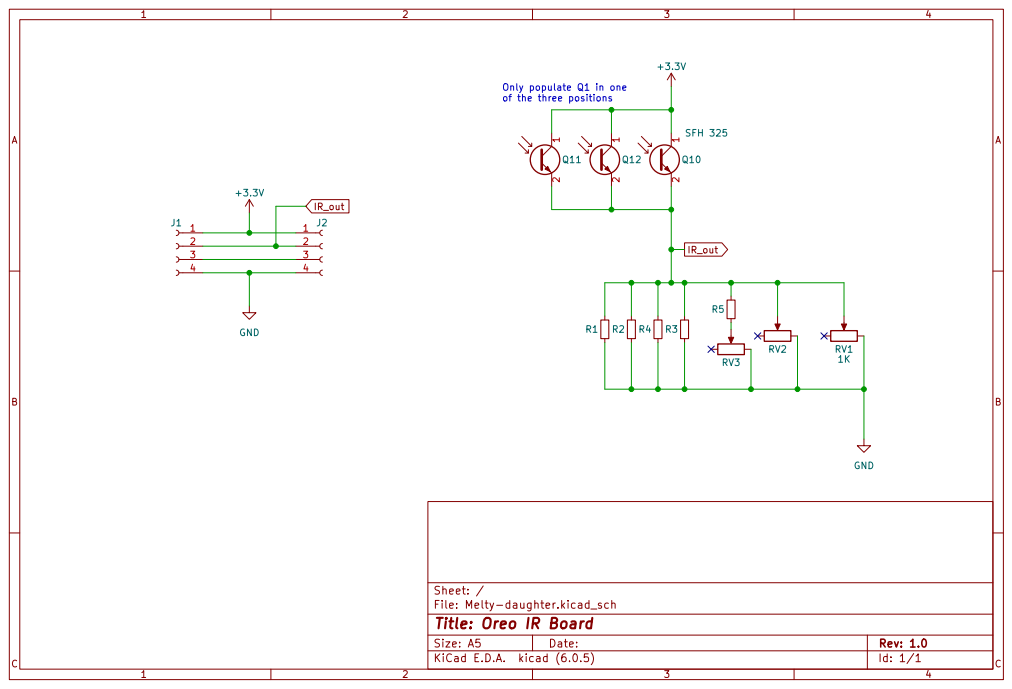
[picture p39: page 1]

IR_out Only populate Q1 in one
of the three positions

File: Melty-daughter.kicad_sch Sheet: / GND

Id: 1/1 Title: Oreo IR Board
