BTSC10/Oreo/PCB/Kicad/Beacon-driver/Beacon-driver.pdf

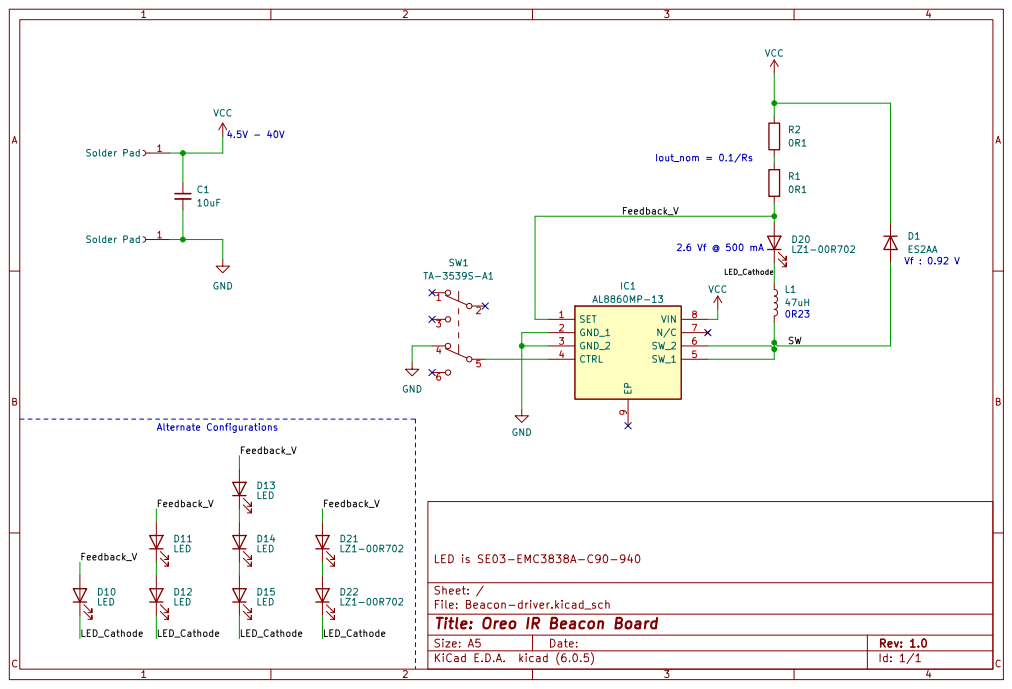
[picture p40: page 1]

VCC

Id: 1/1 Title: Oreo IR Beacon Board
