BTSC10/Oreo/PCB/Kicad/Main-Board/v1.0/Front-Fab-Sheet.pdf

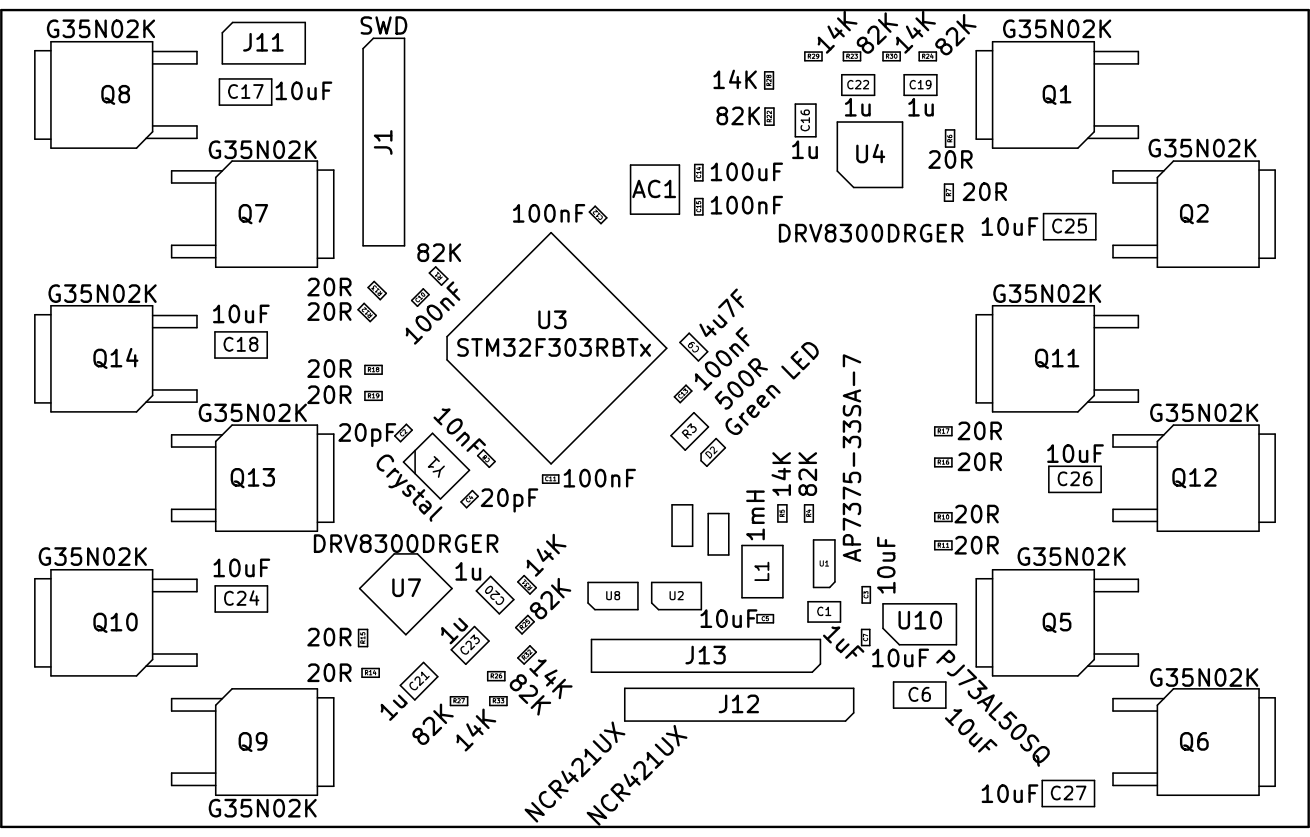
[picture p41: page 1]
