BTSC10/Oreo/PCB/Kicad/Main-Board/v1.0/Melty.kicad_pcb

## KiCad design PCB/Kicad/Main-Board/v1.0/Melty.kicad_pcb (2023-03-07, an earlier design)

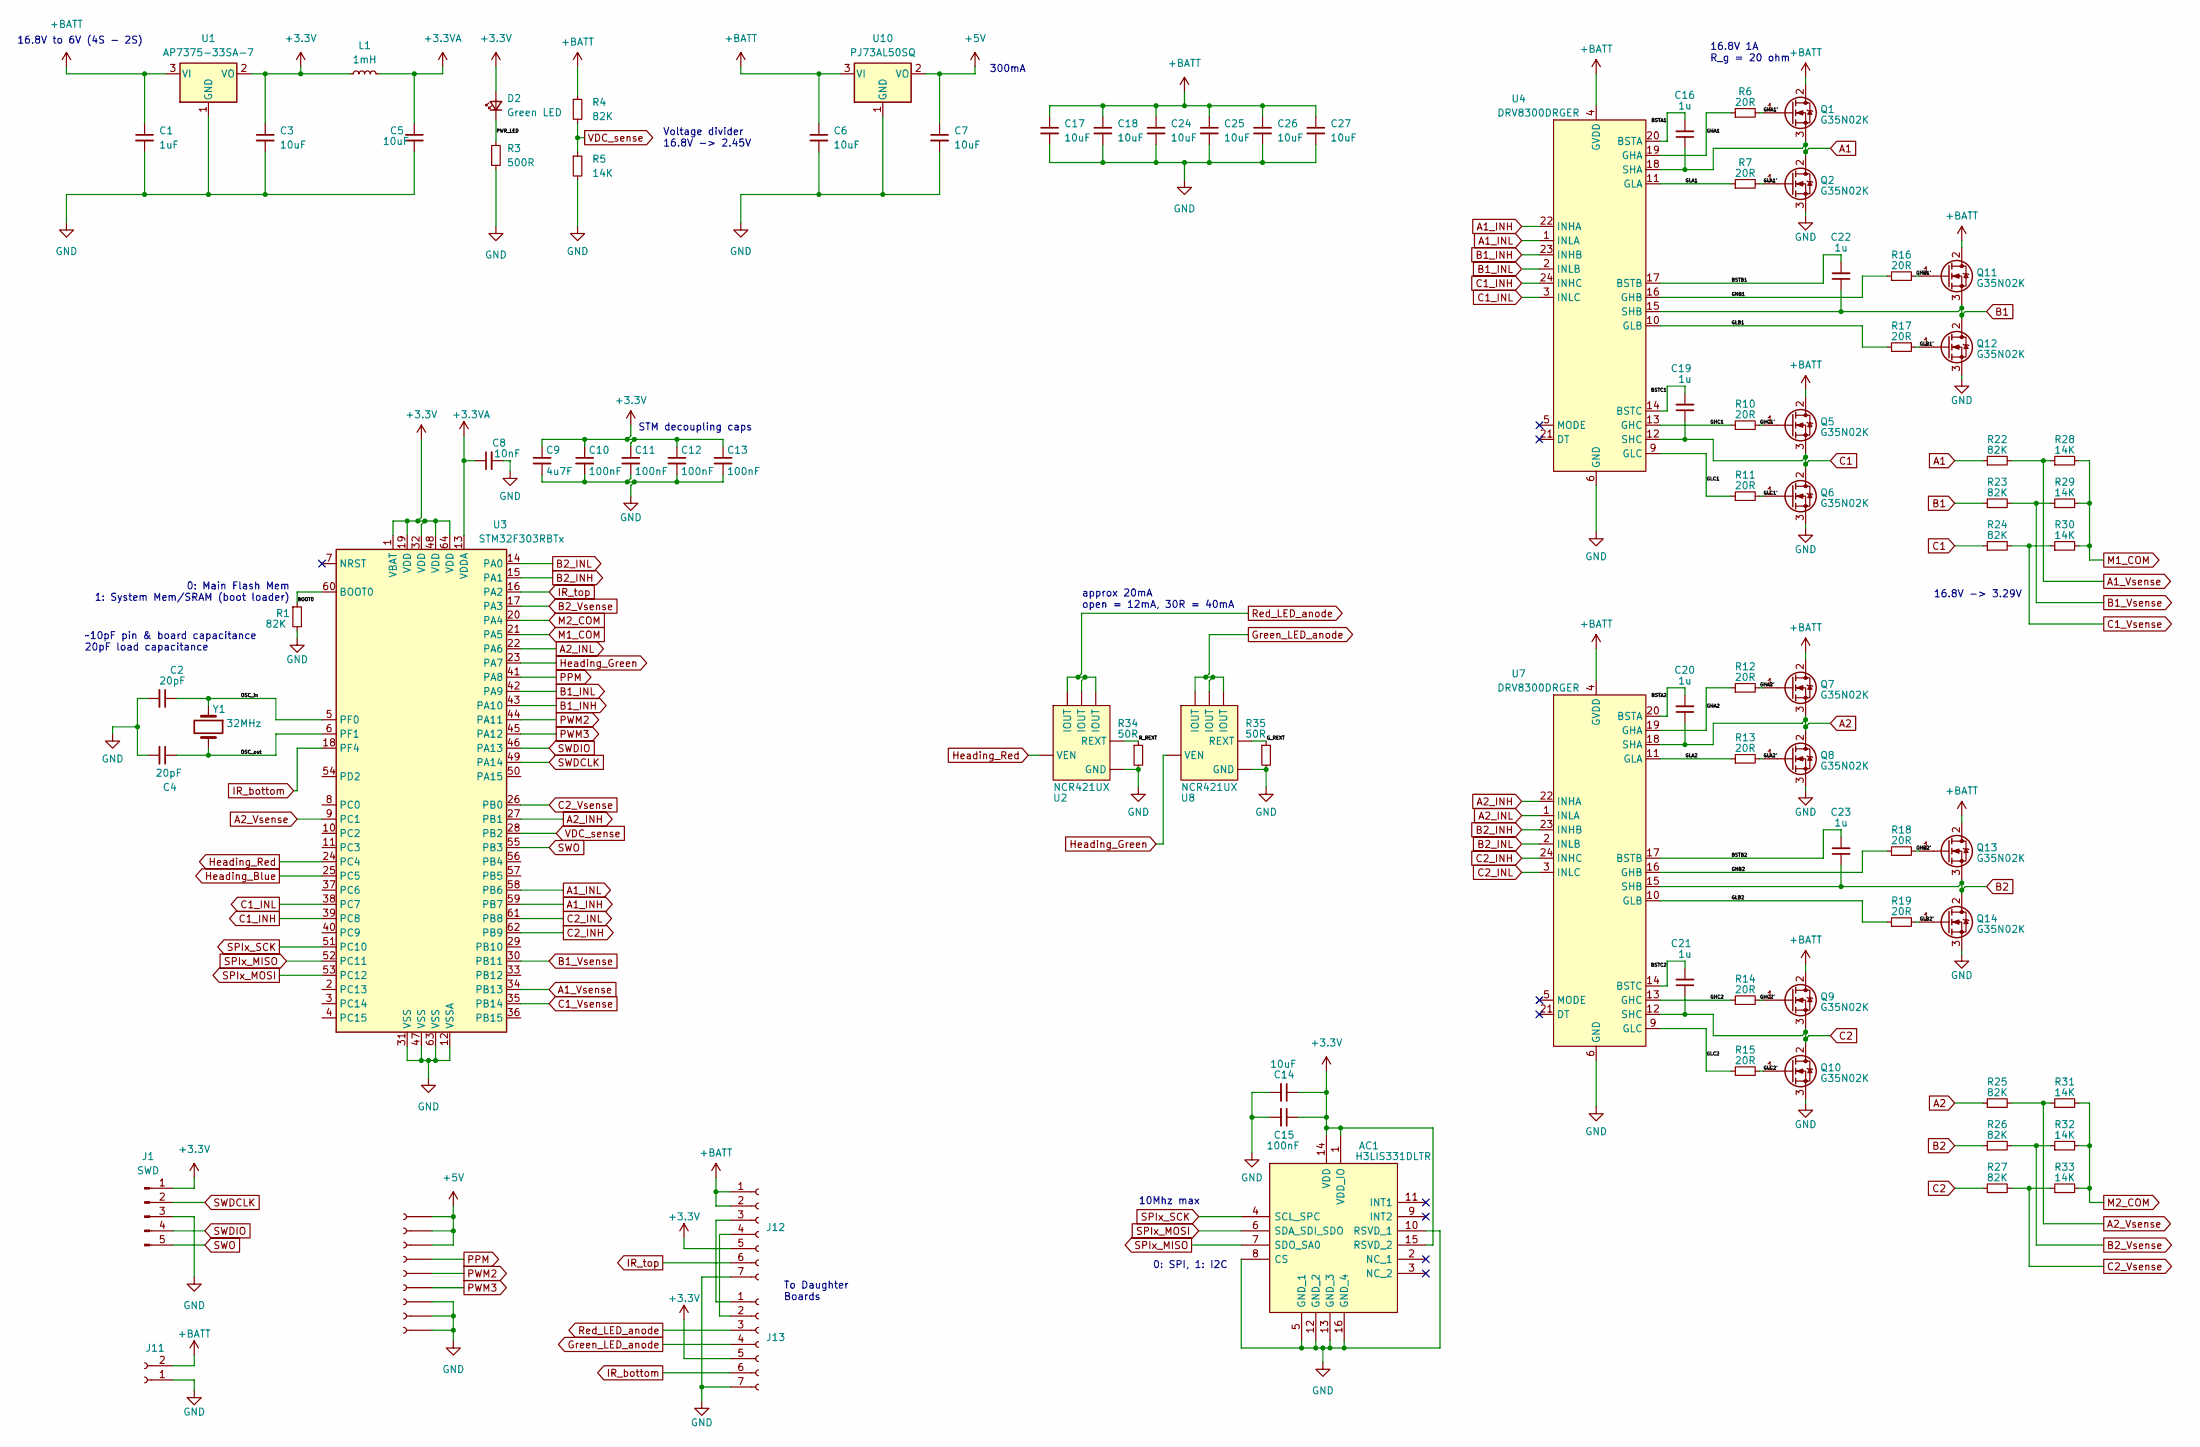
[picture p42: schematic Melty.kicad_sch, Melty Brain Schematic]

Parts:
AC1: H3LIS331DLTR; Manufacturer_Part_Number H3LIS331DLTR; Mouser Part Number 511-H3LIS331DLTR
C1: 1uF; C_0805_2012Metric
C2, C4: 20pF; C_0402_1005Metric
C3, C5, C7, C14: 10uF; C_0402_1005Metric
C6, C17, C18, C24, C25, C26, C27: 10uF; C_1206_3216Metric
C8: 10nF; C_0402_1005Metric
C9: 4u7F; C_0603_1608Metric
C10, C11, C12, C13, C15: 100nF; C_0402_1005Metric
C16, C19, C20, C21, C22, C23: 1u; C_0805_2012Metric
D2: Green LED; LED_0603_1608Metric
J1: SWD; PinHeader_1x05_P2.54mm_Vertical
J2, J3, J4, J5, J6, J7, J8, J9, J10: Conn_01x01_Female; SolderWirePad_1x01_SMD_1x2mm
J11: Conn_01x02_Female; PinSocket_1x02_P2.54mm_Vertical
J12, J13: Conn_01x07_Female; PinSocket_1x07_P2.00mm_Vertical
L1: 1mH; L_1210_3225Metric
Q1, Q2, Q5, Q6, Q7, Q8, Q9, Q10, Q11, Q12, Q13, Q14: G35N02K; TO-252-2
R1, R4, R22, R23, R24, R25, R26, R27: 82K; R_0402_1005Metric
R3: 500R; R_0805_2012Metric
R5, R28, R29, R30, R31, R32, R33: 14K; R_0402_1005Metric
R6, R7, R10, R11, R12, R13, R14, R15, R16, R17, R18, R19: 20R; R_0402_1005Metric
R34, R35: 50R
U1: AP7375-33SA-7; SOT-23
U2, U8: NCR421UX; TSOP-6_1.65x3.05mm_P0.95mm
U3: STM32F303RBTx; LQFP-64_10x10mm_P0.5mm
U4, U7: DRV8300DRGER; VQFN-24-1EP_4x4mm_P0.5mm_EP2.45x2.45mm
U10: PJ73AL50SQ; SOT-89-3
Y1: 32MHz; Crystal_SMD_3225-4Pin_3.2x2.5mm

Connections:
+3.3VA: C5.1, C8.1, L1.2, U3.13 (VDDA)
+3V3: AC1.1 (VDD_IO), AC1.14 (VDD), AC1.15 (RSVD_2), C3.1, C9.1, C10.1, C11.1, C12.1, C13.1, C14.1, C15.1, D2.2 (A), J1.1, J12.5, J13.5, L1.1, U1.2 (VO), U3.1 (VBAT), U3.19 (VDD), U3.32 (VDD), U3.48 (VDD), U3.64 (VDD)
+5V: C7.1, J2.1, J3.1, J4.1, U10.2 (VO)
+BATT: C1.1, C6.1, C17.1, C18.1, C24.1, C25.1, C26.1, C27.1, J11.2, J12.1, J12.2, Q1.2 (D), Q5.2 (D), Q7.2 (D), Q9.2 (D), Q11.2 (D), Q13.2 (D), R4.1, U1.3 (VI), U4.4 (GVDD), U7.4 (GVDD), U10.3 (VI)
/BOOT0: R1.1, U3.60 (BOOT0)
/BSTA1: C16.2, U4.20 (BSTA)
/BSTA2: C20.2, U7.20 (BSTA)
/BSTB1: C22.2, U4.17 (BSTB)
/BSTB2: C23.2, U7.17 (BSTB)
/BSTC1: C19.2, U4.14 (BSTC)
/BSTC2: C21.2, U7.14 (BSTC)
/GHA1: R6.1, U4.19 (GHA)
/GHA1': Q1.1 (G), R6.2
/GHA2: R12.1, U7.19 (GHA)
/GHA2': Q7.1 (G), R12.2
/GHB1: R16.1, U4.16 (GHB)
/GHB1': Q11.1 (G), R16.2
/GHB2: R18.1, U7.16 (GHB)
/GHB2': Q13.1 (G), R18.2
/GHC1: R10.1, U4.13 (GHC)
/GHC1': Q5.1 (G), R10.2
/GHC2: R14.1, U7.13 (GHC)
/GHC2': Q9.1 (G), R14.2
/GLA1: R7.1, U4.11 (GLA)
/GLA1': Q2.1 (G), R7.2
/GLA2: R13.1, U7.11 (GLA)
/GLA2': Q8.1 (G), R13.2
/GLB1: R17.1, U4.10 (GLB)
/GLB1': Q12.1 (G), R17.2
/GLB2: R19.1, U7.10 (GLB)
/GLB2': Q14.1 (G), R19.2
/GLC1: R11.1, U4.9 (GLC)
/GLC1': Q6.1 (G), R11.2
/GLC2: R15.1, U7.9 (GLC)
/GLC2': Q10.1 (G), R15.2
/G_REXT: R35.1, U8.6 (REXT)
/OSC_in: C2.1, U3.5 (PF0), Y1.1
/OSC_out: C4.1, U3.6 (PF1), Y1.3
/PWR_LED: D2.1 (K), R3.1
/R_REXT: R34.1, U2.6 (REXT); also elsewhere on the board
A1: C16.1, Q1.3 (S), Q2.2 (D), R22.1, U4.18 (SHA)
A1_INH: U3.59 (PB7), U4.22 (INHA)
A1_INL: U3.58 (PB6), U4.1 (INLA)
A1_Vsense: R22.2, R28.1, U3.34 (PB13)
A2: C20.1, Q7.3 (S), Q8.2 (D), R25.1, U7.18 (SHA)
A2_INH: U3.27 (PB1), U7.22 (INHA)
A2_INL: U3.22 (PA6), U7.1 (INLA)
A2_Vsense: R25.2, R31.1, U3.9 (PC1)
B1: C22.1, Q11.3 (S), Q12.2 (D), R23.1, U4.15 (SHB)
B1_INH: U3.43 (PA10), U4.23 (INHB)
B1_INL: U3.42 (PA9), U4.2 (INLB)
B1_Vsense: R23.2, R29.1, U3.30 (PB11)
B2: C23.1, Q13.3 (S), Q14.2 (D), R26.1, U7.15 (SHB)
B2_INH: U3.15 (PA1), U7.23 (INHB)
B2_INL: U3.14 (PA0), U7.2 (INLB)
B2_Vsense: R26.2, R32.1, U3.17 (PA3)
C1: C19.1, Q5.3 (S), Q6.2 (D), R24.1, U4.12 (SHC)
C1_INH: U3.39 (PC8), U4.24 (INHC)
C1_INL: U3.38 (PC7), U4.3 (INLC)
C1_Vsense: R24.2, R30.1, U3.35 (PB14)
C2: C21.1, Q9.3 (S), Q10.2 (D), R27.1, U7.12 (SHC)
C2_INH: U3.62 (PB9), U7.24 (INHC)
C2_INL: U3.61 (PB8), U7.3 (INLC)
C2_Vsense: R27.2, R33.1, U3.26 (PB0)
GND: AC1.5 (GND_1), AC1.8 (CS), AC1.10 (RSVD_1), AC1.12 (GND_2), AC1.13 (GND_3), AC1.16 (GND_4), C1.2, C2.2, C3.2, C4.2, C5.2, C6.2, C7.2, C8.2, C9.2, C10.2, C11.2, C12.2, C13.2, C14.2, C15.2, C17.2, C18.2, C24.2, C25.2, C26.2, C27.2, J1.3, J8.1, J9.1, J10.1, J11.1, J12.7, J13.7, Q2.3 (S), Q6.3 (S), Q8.3 (S), Q10.3 (S), Q12.3 (S), Q14.3 (S), R1.2, R3.2, R5.2, R34.2, R35.2, U1.1 (GND), U2.4 (GND), U3.12 (VSSA), U3.31 (VSS), U3.47 (VSS), U3.63 (VSS), U4.6 (GND), U7.6 (GND), U8.4 (GND), U10.1 (GND); also elsewhere on the board
Green_LED_anode: J13.4, U8.2 (IOUT), U8.3 (IOUT), U8.5 (IOUT)
Heading_Blue: U3.25 (PC5)
Heading_Green: U3.23 (PA7), U8.1 (VEN)
Heading_Red: U2.1 (VEN), U3.24 (PC4)
IR_bottom: J13.6, U3.18 (PF4)
IR_top: J12.6, U3.16 (PA2)
M1_COM: R28.2, R29.2, R30.2, U3.21 (PA5)
M2_COM: R31.2, R32.2, R33.2, U3.20 (PA4)
unnamed: J12.3, J13.1
unnamed: J12.4, J13.2
PPM: J5.1, U3.41 (PA8)
PWM2: J6.1, U3.44 (PA11)
PWM3: J7.1, U3.45 (PA12)
Red_LED_anode: J13.3, U2.2 (IOUT), U2.3 (IOUT), U2.5 (IOUT)
SPIx_MISO: AC1.7 (SDO_SA0), U3.52 (PC11)
SPIx_MOSI: AC1.6 (SDA_SDI_SDO), U3.53 (PC12)
SPIx_SCK: AC1.4 (SCL_SPC), U3.51 (PC10)
SWDCLK: J1.2, U3.49 (PA14)
SWDIO: J1.4, U3.46 (PA13)
SWO: J1.5, U3.55 (PB3)
VDC_sense: R4.2, R5.1, U3.28 (PB2)

Notes on the sheet:
16.8V 1A R_g = 20 ohm
To Daughter Boards
16.8V -> 3.29V
~10pF pin & board capacitance 20pF load capacitance
300mA
approx 20mA open = 12mA, 30R = 40mA
10Mhz max
STM decoupling caps
Voltage divider 16.8V -> 2.45V
16.8V to 6V (4S - 2S)
0: SPI, 1: I2C
0: Main Flash Mem 1: System Mem/SRAM (boot loader)

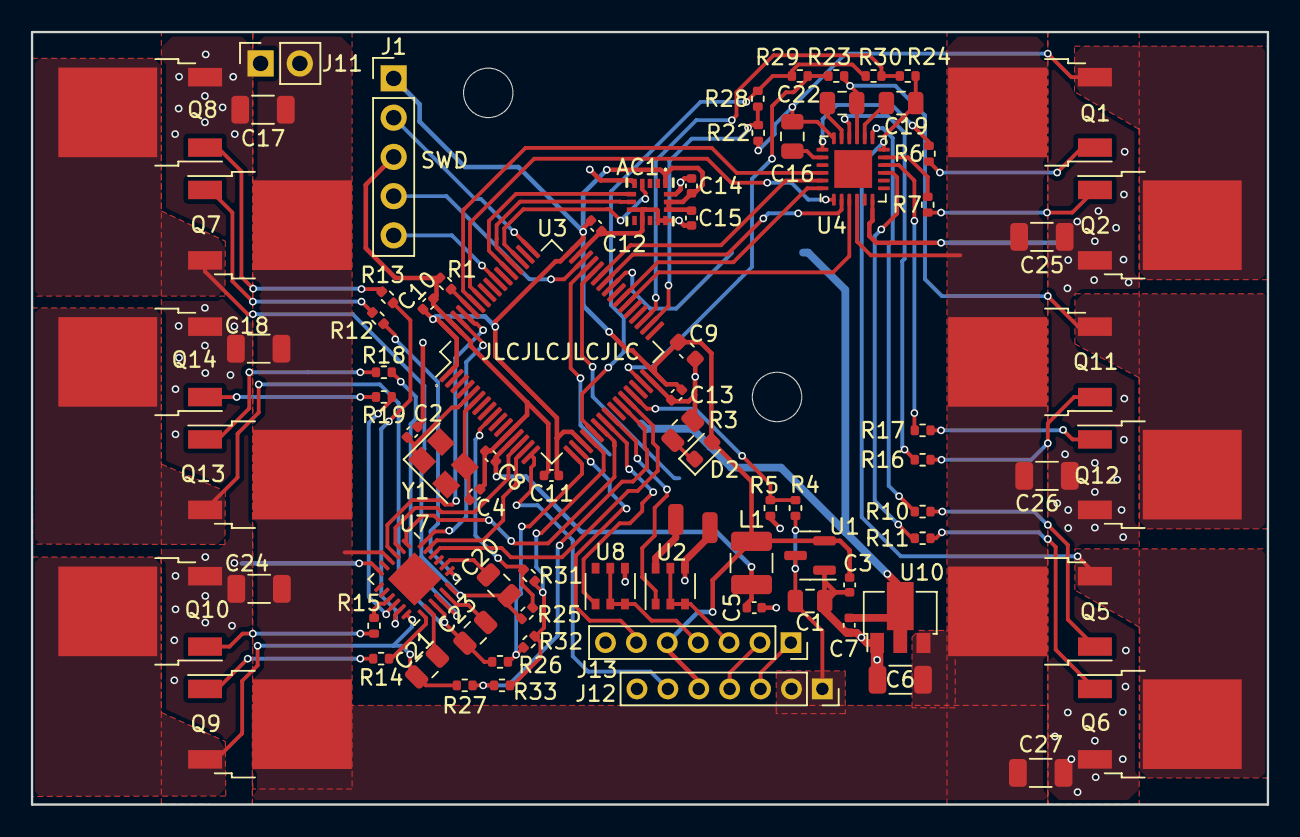
[picture p43: board Melty.kicad_pcb from above]

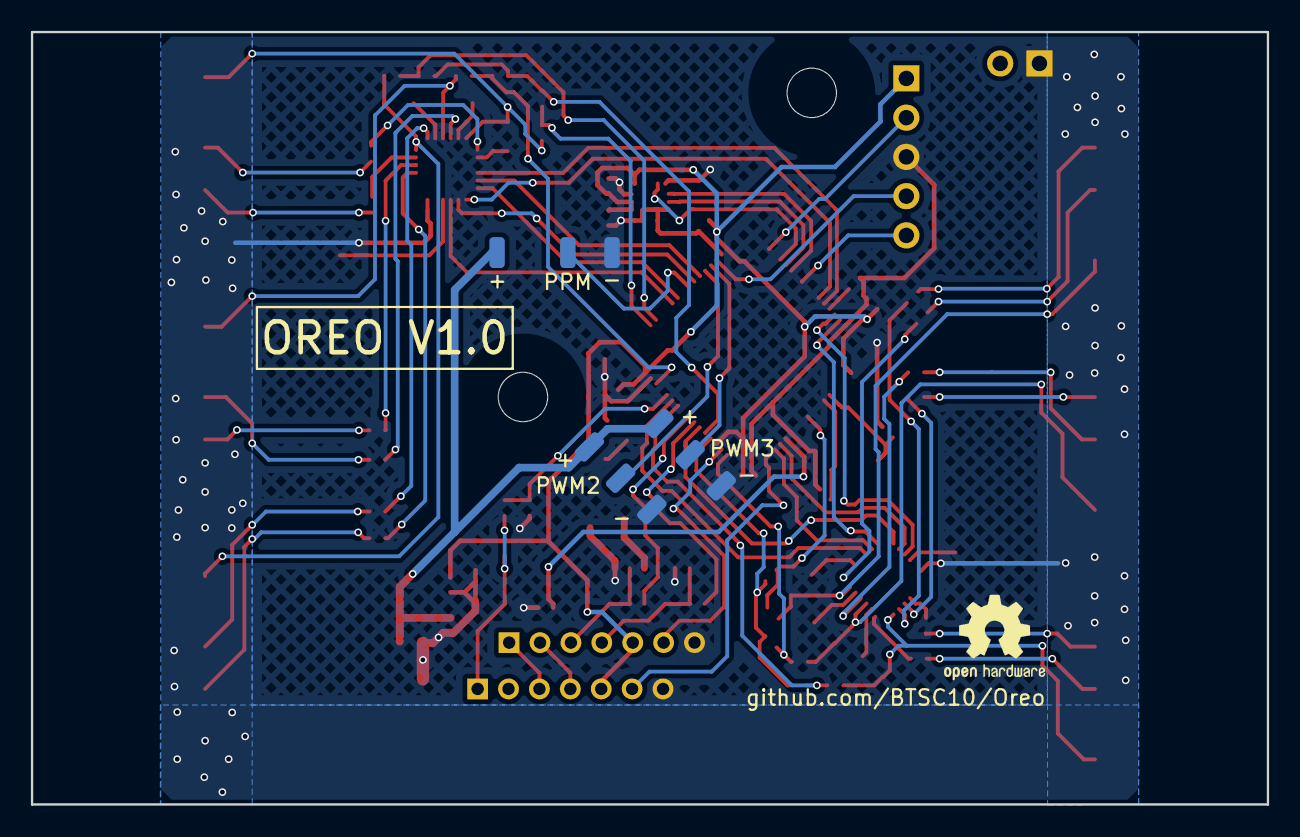
[picture p44: board Melty.kicad_pcb from below]

Board: 2 copper layers, 80.0 x 50.0 mm, 93 parts (9 on the bottom side), 84 nets.

Other parts of the board:
J14, J15: Conn_01x01_Female; SolderWirePad_1x01_SMD_1x2mm

Their connections:
/R_REXT: J14.1; also elsewhere on the board
GND: J15.1; also elsewhere on the board
