BTSC10/Oreo/PCB/Kicad/Daughter-Board/Melty-daughter.kicad_pcb

## KiCad design PCB/Kicad/Daughter-Board/Melty-daughter.kicad_pcb (2023-08-08)

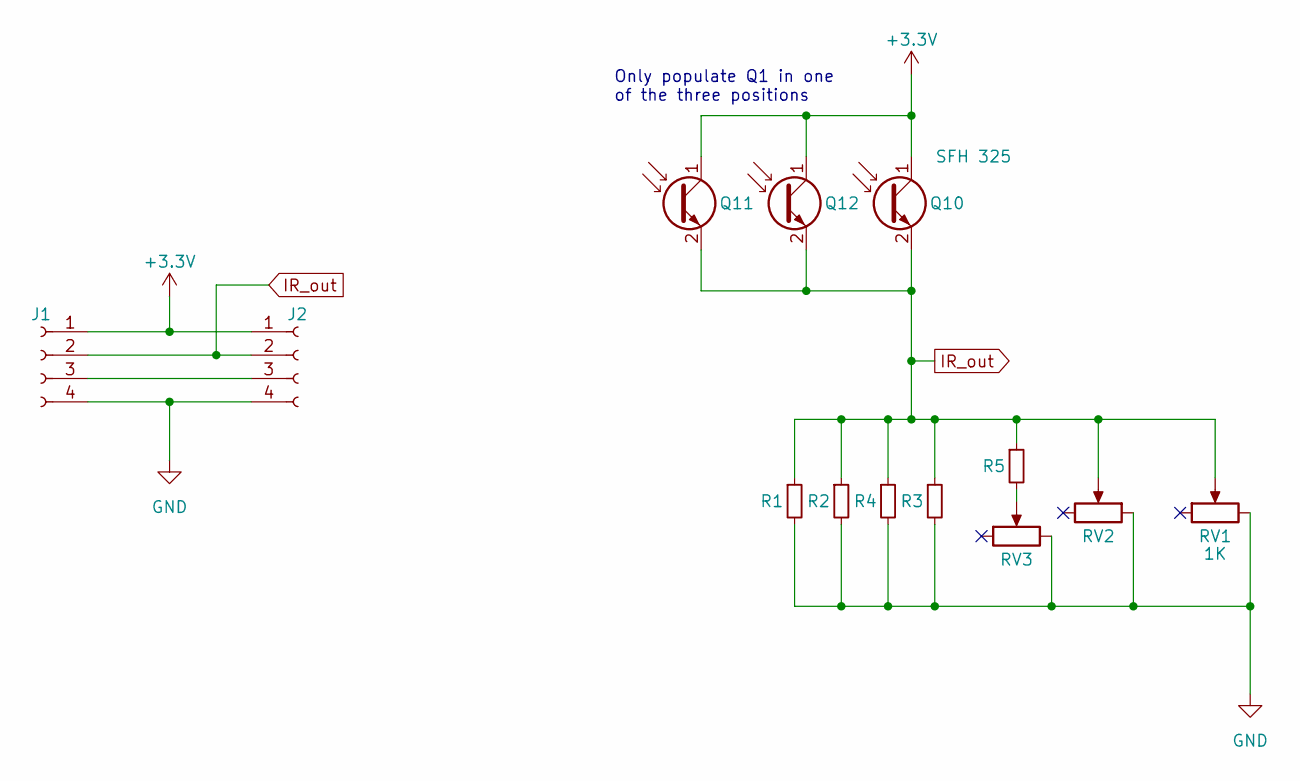
[picture p45: schematic Melty-daughter.kicad_sch, Oreo IR Board]

Parts:
J1, J2: Conn_01x04_Female; PinHeader_1x04_P2.54mm_Vertical
Q10, Q11, Q12: SFH 325; SFH325FA34Z
R1: R; R_0603_1608Metric_Pad0.98x0.95mm_HandSolder
R2, R4: R_Small; R_0805_2012Metric_Pad1.20x1.40mm_HandSolder
R3, R5: R_Small; R_Axial_DIN0204_L3.6mm_D1.6mm_P7.62mm_Horizontal
RV1, RV3: 1K; Potentiometer_Bourns_TC42_Horizontal
RV2: 1K; PinHeader_1x03_P2.54mm_Vertical

Connections:
+3V3: J1.1, J2.1, Q10.1 (C), Q11.1 (C), Q12.1 (C)
GND: J1.4, J2.4, R1.2, R2.2, R3.2, R4.2, RV1.3, RV2.1, RV3.3; also elsewhere on the board
IR_out: J1.2, J2.2, Q10.2 (E), Q11.2 (E), Q12.2 (E), R1.1, R2.1, R3.1, R4.1, R5.1, RV1.2, RV2.2; also elsewhere on the board
unnamed: J1.3, J2.3
unnamed: R5.2, RV3.2

Notes on the sheet:
Only populate Q1 in one of the three positions

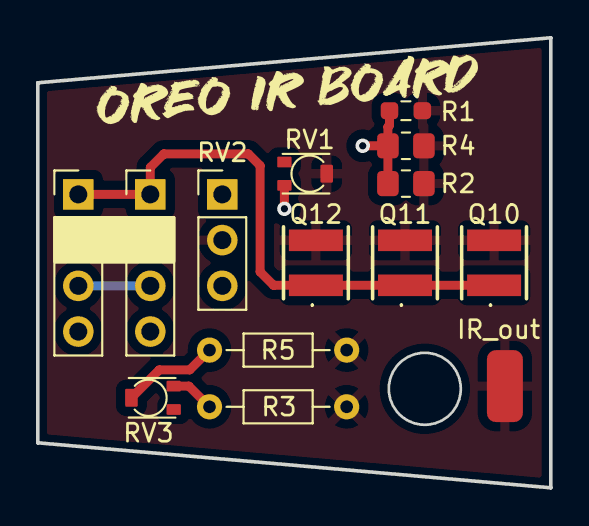
[picture p46: board Melty-daughter.kicad_pcb from above]

Board: 2 copper layers, 28.5 x 25.0 mm, 15 parts (0 on the bottom side), 5 nets.

Other parts of the board:
P1, P2: SolderWirePad_1x01_SMD_1x2mm

Their connections:
GND: P2.1; also elsewhere on the board
IR_out: P1.1; also elsewhere on the board
