BTSC10/Oreo/PCB/Kicad/Beacon-driver/Beacon-driver.kicad_pcb

## KiCad design PCB/Kicad/Beacon-driver/Beacon-driver.kicad_pcb (2023-08-08)

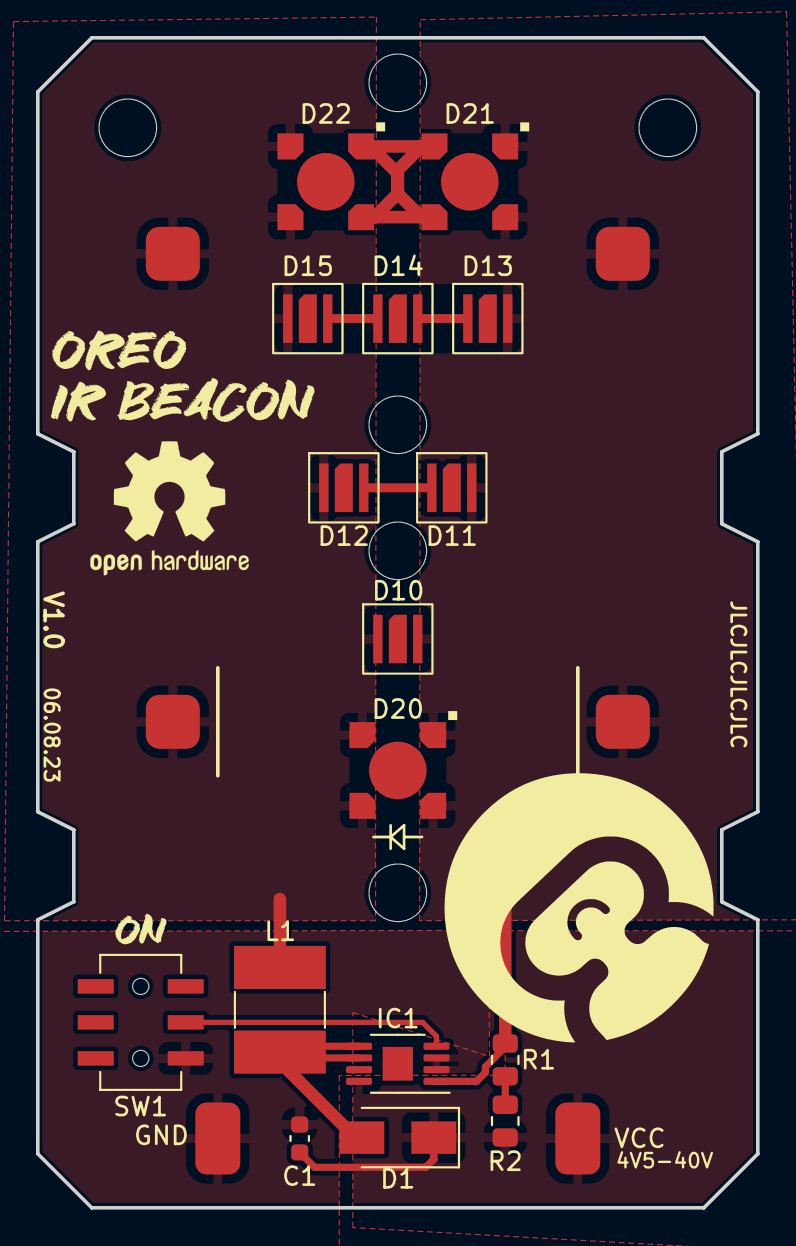
[picture p47: board Beacon-driver.kicad_pcb from above]

Board: 2 copper layers, 40.0 x 65.0 mm, 22 parts (0 on the bottom side), 11 nets.

Parts:
C1: 10uF; C_0603_1608Metric
D1: ES2AA; D_SMA
D10, D11, D12, D13, D14, D15: LED; SE03-EMC3838A-C90-940 (jank led)
D20, D21, D22: LZ1-00R702
GND: SolderWirePad_1x01_SMD_1x2mm
IC1: AL8860MP-13; MSOP-8-1EP_3x3mm_P0.65mm_EP1.68x1.88mm
L1: 47uH; VLS-EX-H
R1, R2: 0R1; R_0805_2012Metric
SW1: TA-3539S-A1; TA-3539S-A1 switch
VCC: SolderWirePad_1x01_SMD_1x2mm
VCC#2, VCC#3, VCC#4, VCC#5: SolderWirePad_1x01_SMD_1x2mm

Connections:
/Feedback_V: D10.2 (A), D11.2 (A), D13.2 (A), D20.2 (A), D21.2 (A), IC1.1 (SET), R1.2, VCC#2.1, VCC#3.1
/LED_Cathode: D10.1 (K), D12.1 (K), D15.1 (K), D20.1 (K), D22.1 (K), L1.1, VCC.1, VCC#4.1
/SW: D1.2 (A), IC1.5 (SW_1), IC1.6 (SW_2), L1.2
GND: C1.2, GND.1, IC1.2 (GND_1), IC1.3 (GND_2), SW1.4 (A)
unnamed: D11.1 (K), D12.2 (A)
unnamed: D13.1 (K), D14.2 (A)
unnamed: D14.1 (K), D15.2 (A)
unnamed: D21.1 (K), D22.2 (A)
unnamed: IC1.4 (CTRL), SW1.5 (B)
unnamed: R1.1, R2.2
VCC: C1.1, D1.1 (K), IC1.8 (VIN), R2.1, VCC#5.1
