BTSC10/Oreo/Software/Oreo.ioc

Mcu.UserName=STM32F303RBTx
PA3.Signal=ADC1_IN4
