BTSC10/Oreo/(commit log)

2022-11-13 initial schematic commit
    First draft for the custom PCB schematics
    [Melty.kicad_pcb, Melty.kicad_sch, STM32F303_pinout.xlsx]
2022-12-06 Added BOM
    [BOM.xlsx]
2022-12-09 updated BOM
    [BOM.xlsx]
2022-12-09 Updated PCB files
    updated PCB files with a semi final version of the schematic and PCB design for Oreo
    [Melty-daughter.kicad_pcb, Melty-daughter.kicad_sch, Melty.kicad_pcb, Melty.kicad_sch, Melty_PCB.SLDASM, STM32F303_pinout.xlsx]
2022-12-09 Updated CAD
    Added Solidworks files with rough mechanical construction of the bot
    [C2836_Brushless_Motor.SLDPRT, Lasercut_layout.SLDASM, Lower_Top_Plate.SLDPRT, Melty.SLDASM, Mid_Plate.SLDPRT, Mock_PCB.SLDPRT, Motor_Shim.SLDPRT, Outer_Ring.SLDPRT]
2023-02-22 Updated CAD (v2)
    [3mm_LED.SLDPRT, DesignA.SLDPRT, M2.5 Nut.step.SLDPRT, Melty.SLDASM, Nylon Housing.step.SLDPRT, Socket 3.5mm.step.SLDPRT, Wheel.SLDPRT, XT60E-F.SLDASM]
2023-02-22 Updated BOM
    added weight calculations
    [BOM.xlsx]
2023-03-05 Final V1.0 Oreo main PCB
    [Melty-daughter.kicad_pcb, Melty-daughter.kicad_sch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]
2023-03-05 Updated BOM
    marked components that have arrived
    [BOM.xlsx]
2023-03-05 CAD V2.0
    [3mm_LED.SLDPRT, C2836_Brushless_Motor.SLDPRT, DesignA.SLDPRT, Lasercut_layout.SLDASM, Lower_Top_Plate.SLDPRT, M2.5 Nut.step.SLDPRT, Melty.SLDASM, Mid_Plate.SLDPRT]
2023-03-07 Added front fab Layer
    [Melty.kicad_pcb]
2023-06-01 Add Beacon Driver components
    [BOM.xlsx]
2023-06-12 Add Beacon driver files
    Add schematic for the circuit that will drive the high power IR beacon LED.
    Add initial tests of the prototype circuit.
    [Beacon-driver.kicad_pcb, Beacon-driver.kicad_sch]
2023-08-08 Add Beacon schematic and PCB design
    Add Kicad files for the schematic and PCB of the beacon circuit
    [Beacon-driver-B_Cu.gbr, Beacon-driver-B_Mask.gbr, Beacon-driver-B_Paste.gbr, Beacon-driver-B_Silkscreen.gbr, Beacon-driver-Edge_Cuts.gbr, Beacon-driver-F_Cu.gbr, Beacon-driver-F_Mask.gbr, Beacon-driver-F_Paste.gbr]
2023-08-08 Add IR Board schematic and PCB design
    Add kicad files for the schematic and PCB of the IR Board.
    [Melty-daughter-B_Cu.gbr, Melty-daughter-B_Mask.gbr, Melty-daughter-B_Paste.gbr, Melty-daughter-B_Silkscreen.gbr, Melty-daughter-Edge_Cuts.gbr, Melty-daughter-F_Cu.gbr, Melty-daughter-F_Mask.gbr, Melty-daughter-F_Paste.gbr]
2023-08-08 Add Main Board schematic and PCB design
    Add kicad files for the Main Board schematic and PCB.
    [Melty-B_Cu.gbr, Melty-B_Mask.gbr, Melty-B_Paste.gbp, Melty-B_Paste.gbr, Melty-B_Silkscreen.gbo, Melty-B_Silkscreen.gbr, Melty-Edge_Cuts.gbr, Melty-F_Cu.gbr]
2023-08-08 Separate BOM for each PCB
    Add separate BOM for the Main Board, IR Board, and IR Beacon
    [BOM.xlsx]
